ultrazohm/uz_d_gan_inverter_epc/GaN_Inverter/TikzCircuits/ThreePhaseInverter.tex

\documentclass{article}
\usepackage[fulldiodes]{circuitikz}
\usepackage{caption}
\usepackage{subcaption}
\usepackage{circuitikz}
\usepackage{graphicx}

\begin{document}
	
		\centering

		\begin{circuitikz}[scale=1.6]
			
			\centering
			
			\ctikzset{bipoles/resistor/height=0.15}
			\ctikzset{bipoles/resistor/width=0.4}
			\ctikzset{resistor = european}

			\draw (-1,2) to[european voltage source,v_=$V_{DC}$] ++(0,-3.77);
			\draw (-1,2)--(0,2) node[circ]{}  to[C,l=$C$] ++(0,-3.76) node[circ]{};
			
			\draw (0,2) to ++(2,0)  node[circ]{}
			to (6,2) -- ++(0,-0.3) node[Lnigbt,bodydiode,anchor=D,label={[label distance=10]100:$$}](S3){};
			
			\draw (4,2) node[circ]{};
			\draw (2,-1.76) node[circ]{};
			\draw (4,-1.76) node[circ]{};
			\draw (S3.E)  to (6,0)  node[circ,label={180:$V_{C}$}](vc){}
			to (6,-.5) node[Lnigbt,bodydiode,anchor=D,label={[label distance=10]100:$$}](s3){};
			\draw (s3.E) to ++(0,-0.3) to ++(-4,0);

			\draw (S3.B) node[circ,label={90:{$S_3$}}]{};
			\draw (s3.B) node[circ,label={90:{$S^*_3$}}]{};
			
			\draw (2,2) -- ++(0,-0.3) node[Lnigbt,bodydiode,anchor=D,label={[label 	distance=10]100:$$}](S1){} ;
			\draw (S1.E) to (2,0)  node[circ,label={180:$V_{A}$}](va){}
			to (2,-.5) node[Lnigbt,bodydiode,anchor=D,label={[label distance=10]100:$$}](s1){};
			\draw (s1.E) to ++(0,-0.3)  to  ++(-2,0) to [/tikz/circuitikz/bipoles/length=25pt, R = $R_{dc}$] ++(-1,0);
			\draw (S1.B) node[circ,label={90:{$S_1$}}]{};
			\draw (s1.B) node[circ,label={90:{$S^*_1$}}]{};
			
			\draw (4,2) -- ++(0,-0.3)   node[Lnigbt,bodydiode,anchor=D,label={[label distance=10]100:$$}](S2){};
			\draw (S2.E) to (4,0)  node[circ,label={180:$V_{B}$}](vb){}
			to (4,-.5) node[Lnigbt,bodydiode,anchor=D,label={[label distance=10]100:$$}](s2){};
			\draw (S2.B) node[circ,label={90:{$S_2$}}]{};
			\draw (s2.B) node[circ,label={90:{$S^*_2$}}]{};
			
			\draw (4,-1.46) -- ++(0,-0.3);
			\draw (2,-1.46) -- ++(0,-0.3);
			
			\draw (va) to ++(.75,0) to ++(0, -1.5) 
			to[/tikz/circuitikz/bipoles/length=25pt, R = $R_{s1}$] ++(0,-1.5)  node[ocirc]{};
			\draw (vb) to ++(.75,0) to ++(0, -1.5) 
			to[/tikz/circuitikz/bipoles/length=25pt, R = $R_{s2}$] ++(0,-1.5)  node[ocirc]{} ;
			\draw (vc) to ++(.75,0) to ++(0, -1.5)
			to[/tikz/circuitikz/bipoles/length=25pt, R = $R_{s3}$] ++(0,-1.5)   node[ocirc]{};
			\draw (6,-3.5) to[short, label=Phase 	Connector(1..3), below] ++(0,0);
			
			\path (1.6, 1) -- node[auto=false]{\ldots} ++(-1,0);
			\path (1.7,-1.2) -- node[auto=false]{\ldots} ++(-1,0);
			\path (3.6, 1) -- node[auto=false]{\ldots} ++(-1,0);
			\path (3.7,-1.2) -- node[auto=false]{\ldots} ++(-1,0);
			\path (5.6, 1) -- node[auto=false]{\ldots} ++(-1,0);
			\path (5.7,-1.2) -- node[auto=false]{\ldots} ++(-1,0);

	\end{circuitikz}

	\end{document}
