ultrazohm/uz_d_gan_inverter_epc/GaN_Inverter/HLU_Final_Presentation_Kaan_Ilhan.pdf

Chair of High-Power Converter Systems TUM School of Engineering and Design Technical University of Munich

Kaan Ilhan

M.Sc. Eyke Aufderheide

M.Sc. Tobias Schindler

Gean Maia de Sousa

23rd August, 2023

# Final Presentation of Bachelor’s Thesis

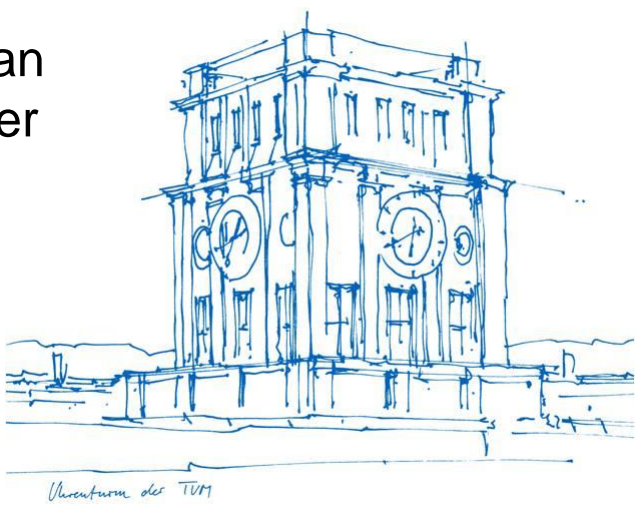
[picture p1: figure]

## Design and Implementation of an 1 kVA Three-Phase GaN Inverter

## Contents

1. Motivation
2. Gallium Nitride Power Transistor
3. Three-phase Two-level GaN Inverter
4. Parasitic Inductances
5. Layout Considerations
6. Thermal Considerations
7. Test and Measurement
8. References

## Motivation

- Using a three-phase two-level GaN inverter within

UltraZohm

- Improving the gate driver circuit of the existing GaN

inverter

- Optimizing the layout of the switching cells
- Implementing and commisioning
- Performance and thermal measurements

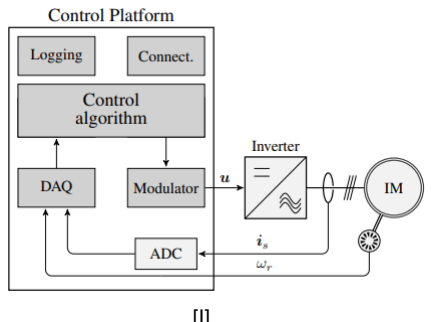
[picture p2: figure]

[I]

## Gallium Nitride Power Transistor

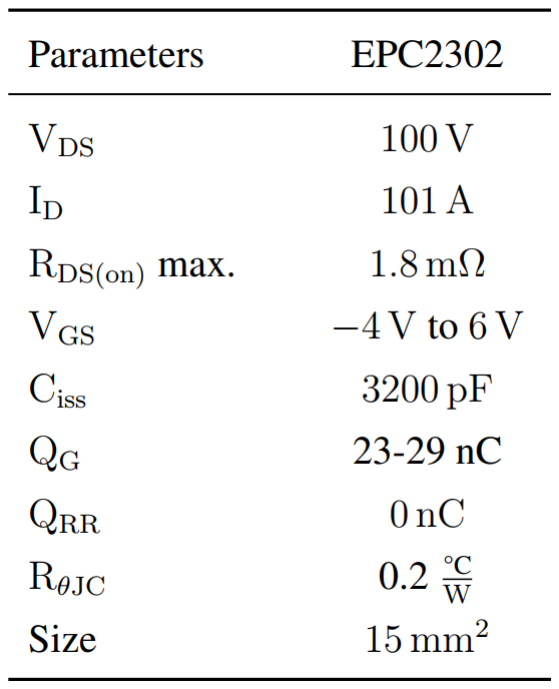
[picture p3: figure]

MOSFET Inverter

GaN Inverter

Benefits:

- Higher switching speed
- Higher efficiency
- Lower RDS(ON)

•Thermally enhanced package

- Smaller footprint, high power

density

## Three-phase Two-level GaN Inverter

- Absoulute maximum ratings:
Vdc = 48 V | Iout = 25 A
fPWM = 100 kHz | Tmax = 150°C
- Current and voltage measurements:
IOCP, leg = 40 A | IOCP, phase = 29.85 A

Vpeak = 60 V

- Temperature measurement of GaN HEMTs

Tpeak = 105°C

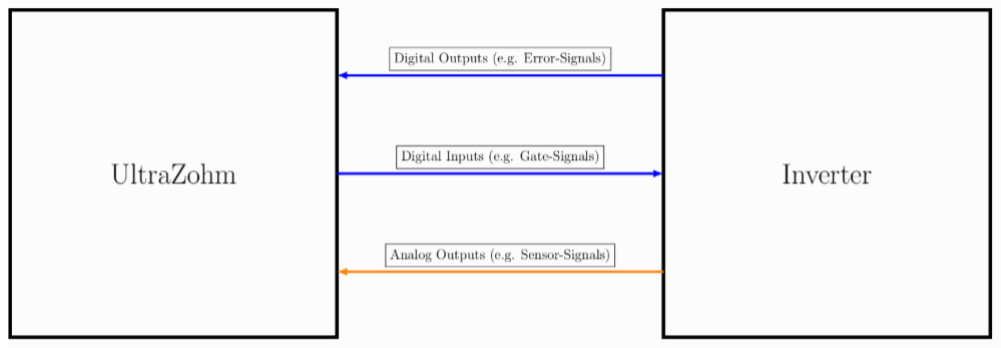
[picture p4: figure]

[II]

## Three-phase Two-level GaN Inverter

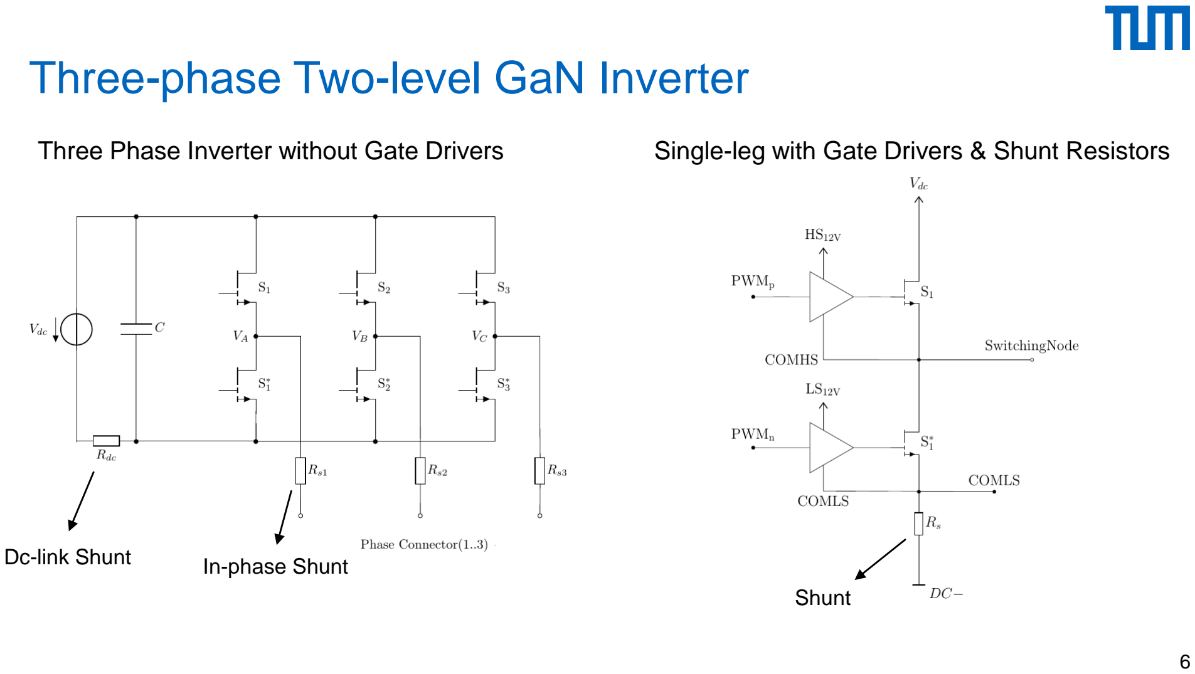
[picture p5: page 6]

Three Phase Inverter without Gate Drivers | Single-leg with Gate Drivers & Shunt Resistors
Dc-link Shunt | In-phase Shunt

Shunt

## Parasitic Inductances

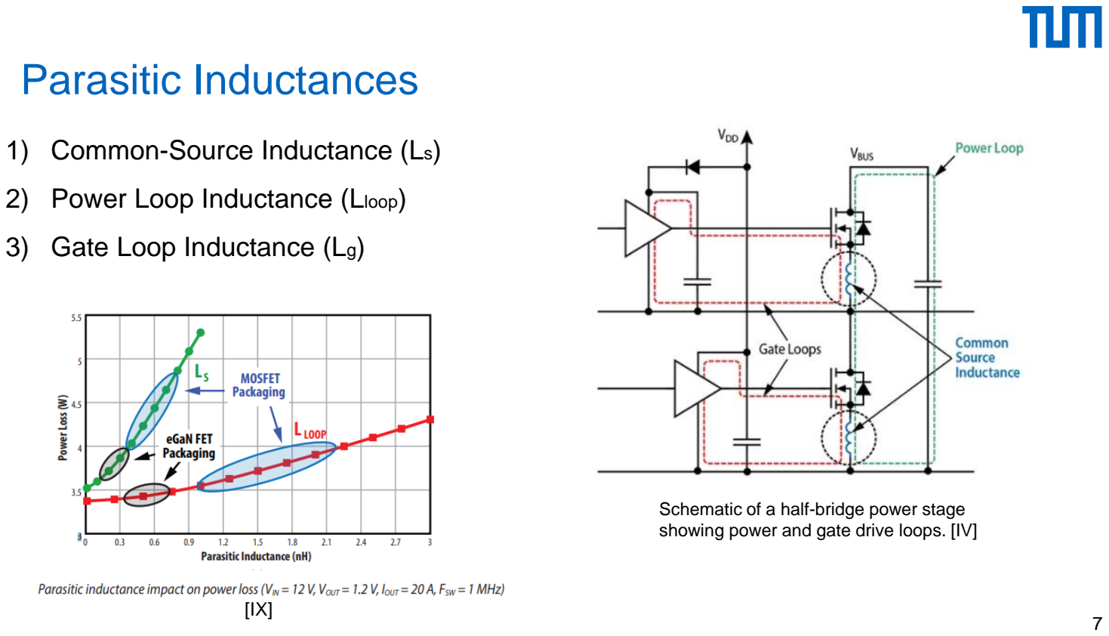
[picture p6: page 7]

1) Common-Source Inductance (Ls)
2) Power Loop Inductance (Lloop)
3) Gate Loop Inductance (Lg)

[IX]

Schematic of a half-bridge power stage showing power and gate drive loops. [IV]

- Ls is mainly controlled by the package inductance
- Overall reduction in parasitic inductance through

magnetic field self-cancellation

CSI is minimized

- Ls is no longer major loss contributor, but Lloop

## Optimal GaN FET Layout

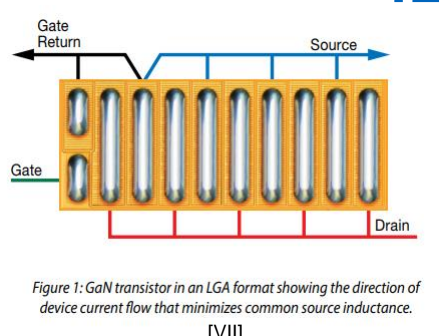
[picture p7: figure]

[VII]

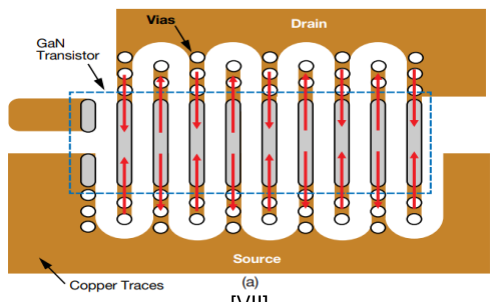
[picture p8: figure]

[VII]

## Comparison of Power Loop Layouts

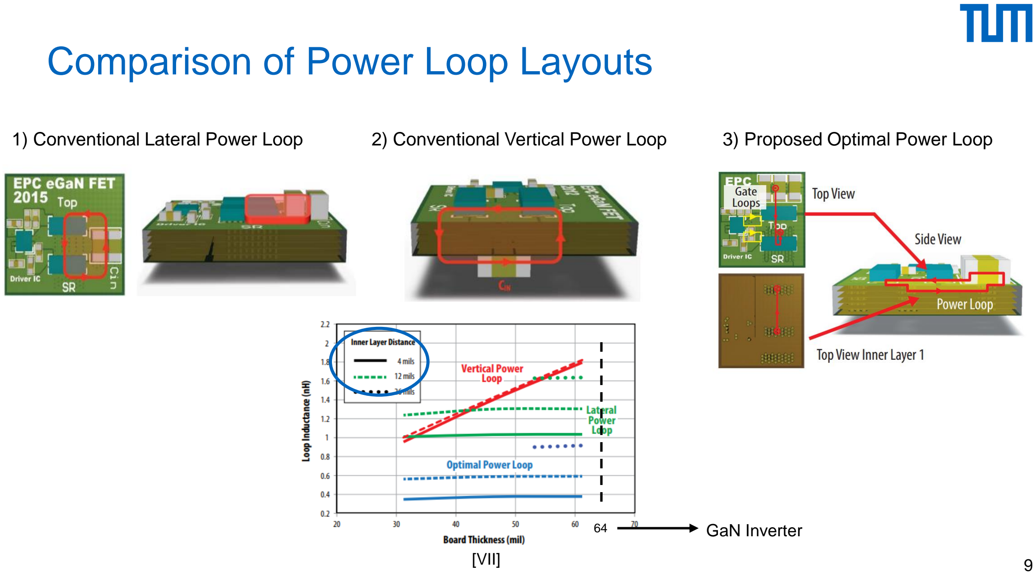
[picture p9: page 9]

64

1) Conventional Lateral Power Loop | 2) Conventional Vertical Power Loop | 3) Proposed Optimal Power Loop

[VII]

GaN Inverter

## Optimal Layout of Power and Gate Loops

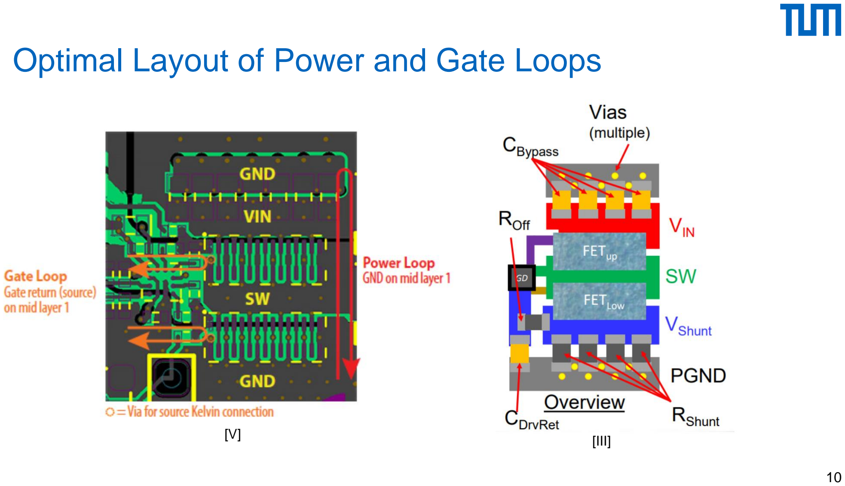
[picture p10: page 10]

[V] | [III]

## Vias Plated Over

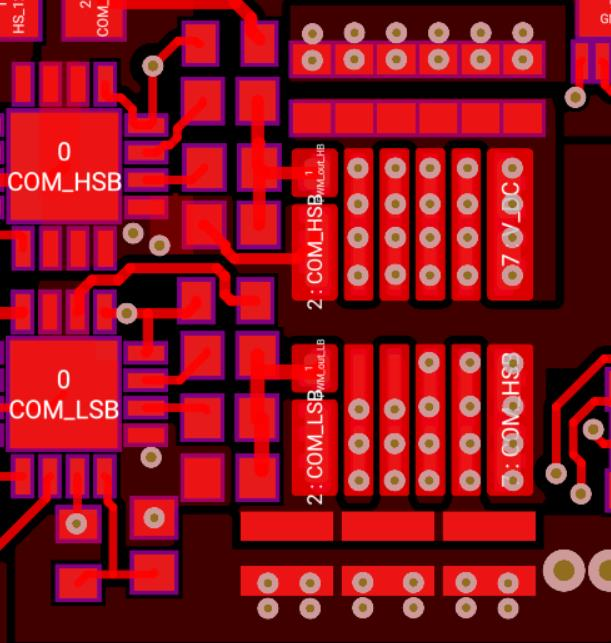
[picture p11: figure]

- Vias must be filled with epoxy and high termal

conductivity copper

- Minimizes the signal path lengths, decreasing

the parasitics

- Costly and complex to produce

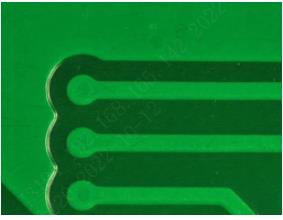
[picture p12: figure]

[VIII]

## Thermal Considerations

- Prepared for a heatsink installation
- Four holes of M3 are placed to allow screws
- Careful placement of thermal vias and power

planes to spread the heat

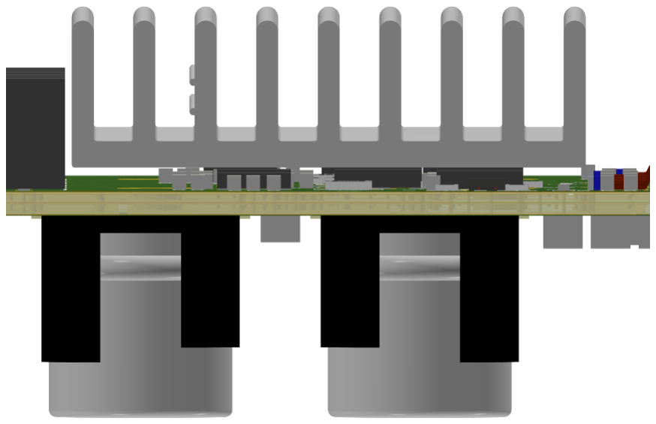
[picture p13: figure]

- Epoxy-filled vias to improve heat dissipation

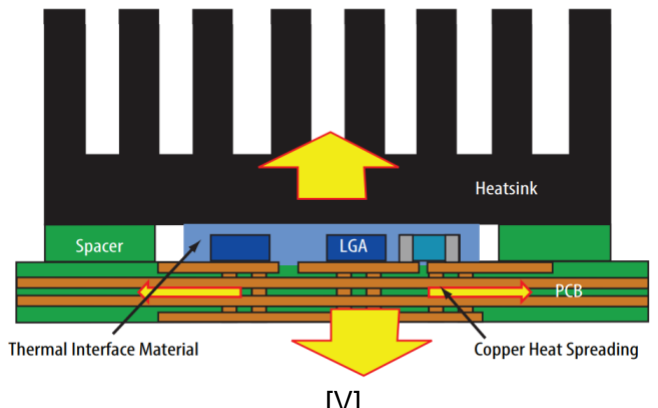
[picture p14: figure]

[V]

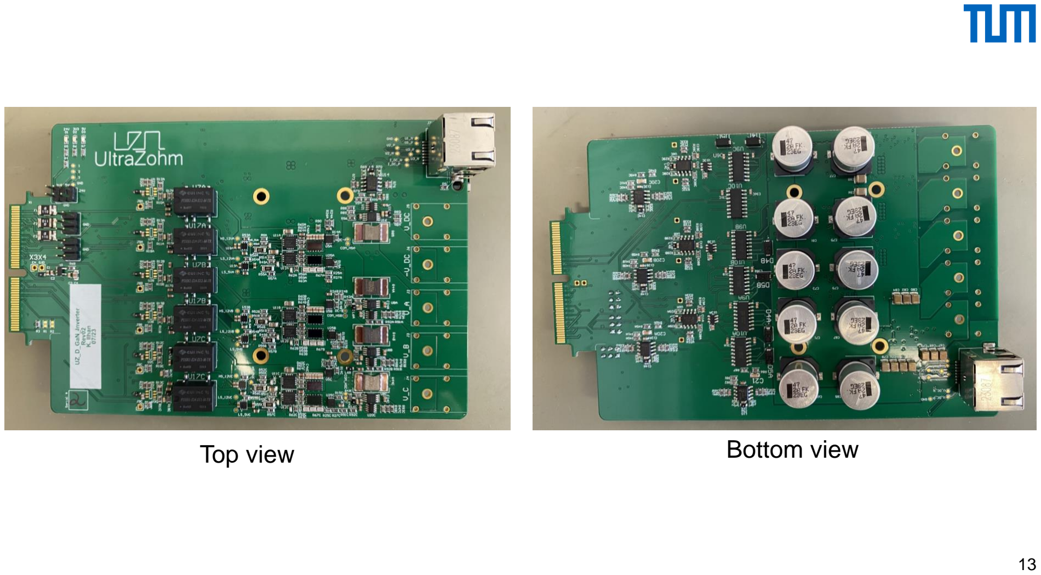
[picture p15: page 13]

Top view | Bottom view

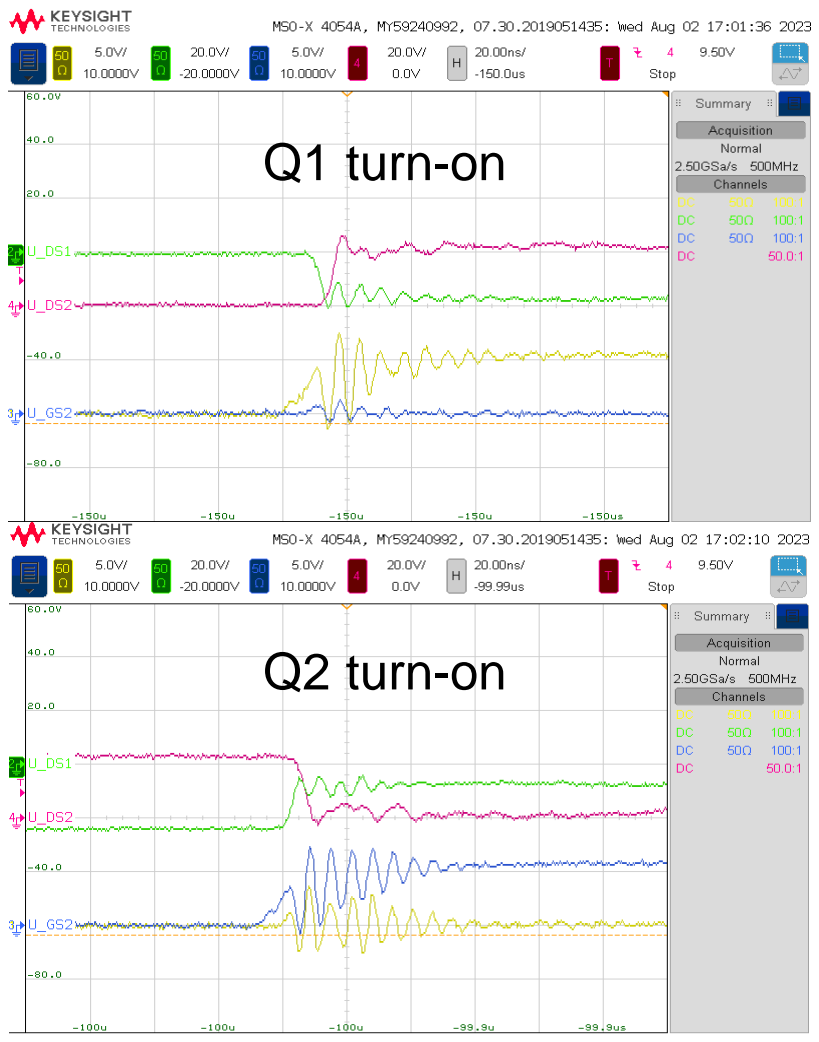
[picture p16: figure]
Q1 turn-on; Q2 turn-on

## Measurement Results (M3)

- VGS1 | yellow
VDS1 | green
- VGS2 | blue
VDS2 | pink
- Vdc = 24 V, fPWM = 10 kHz
- ISRC = 2 A, RON = 2.7 Ω, ROFF = 2.7 Ω

Q1 (top switch)

Q2 (bottom switch)

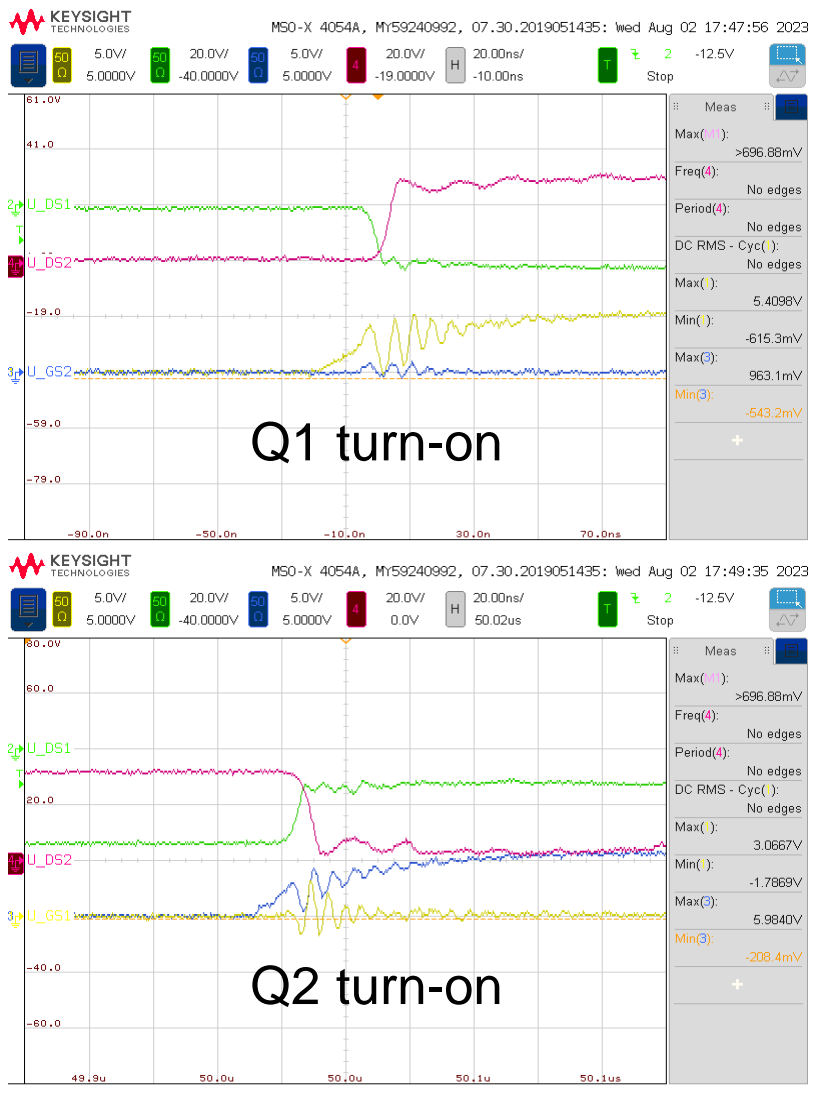
[picture p17: figure]
Q1 turn-on; Q2 turn-on

## Measurement Results (M4)

- VGS1 | yellow
VDS1 | green
- VGS2 | blue
VDS2 | pink
- Vdc = 34 V, fPWM = 10 kHz
- ISRC = 0.75 A, RON = 2.7 Ω, ROFF = 2.7 Ω,

Q1 (top switch)

Q2 (bottom switch)

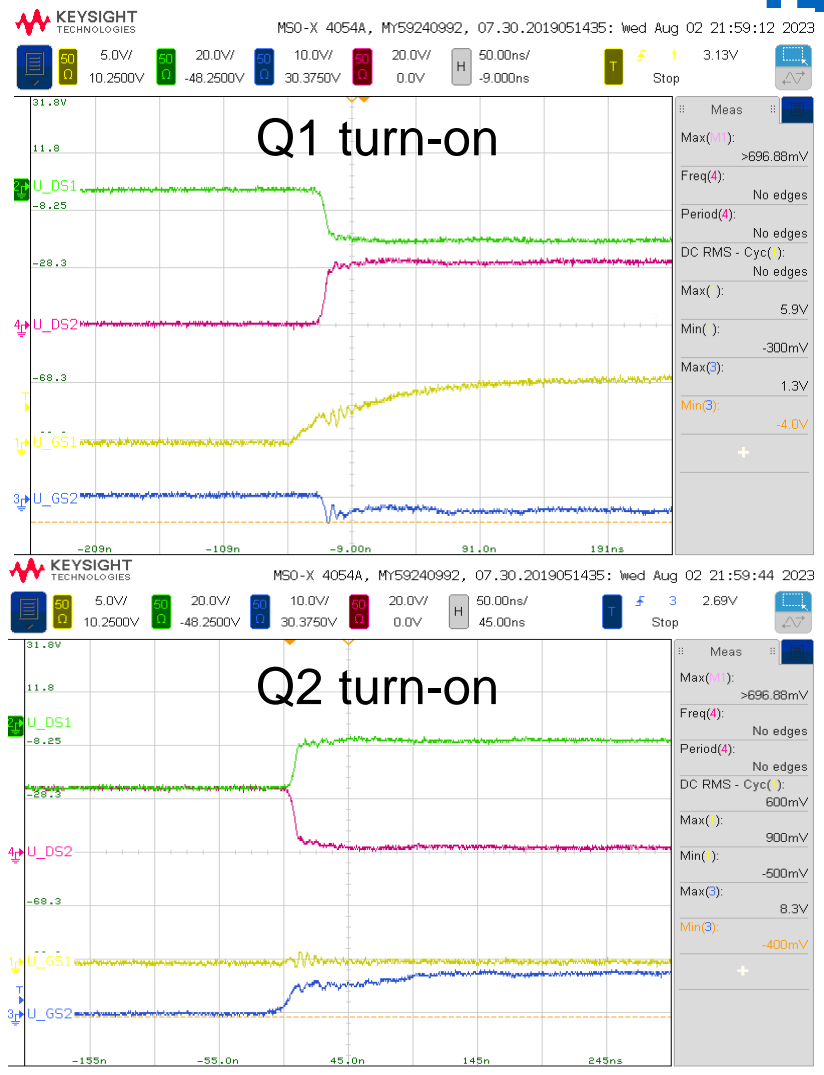
[picture p18: figure]
Q1 turn-on; Q2 turn-on

## Measurement Results (M5)

- VGS1 | yellow
VDS1 | green
- VGS2 | blue
VDS2 | pink
- Vdc = 24 V, fPWM = 10 kHz
- ISRC = 0.75 A, RON = 10 Ω, ROFF = 2.7 Ω,

Q1 (top switch)

Q2 (bottom switch)

## Thermal Measurements

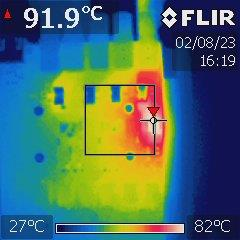
[picture p19: figure]

Temperature measurement with IOUT = 24 A at fPWM = 10 kHz, Vdc = 48 V, ISRC = 0.75 A and RON = 10 Ω, ROFF = 2.7 Ω, dead-time = 1 µs

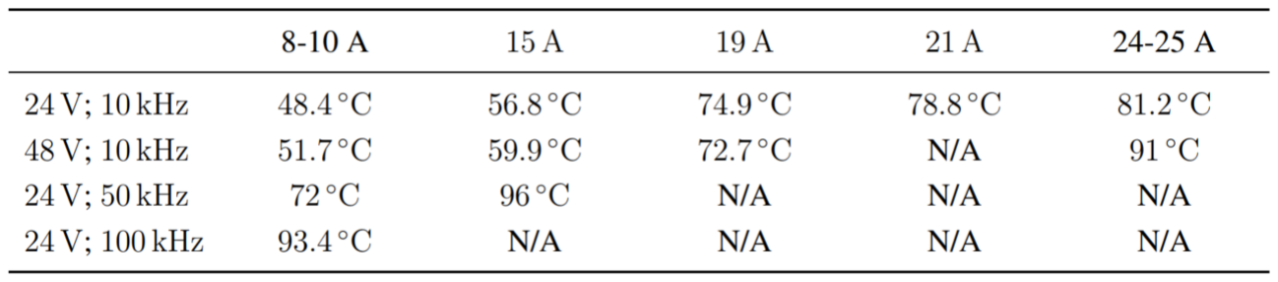
[picture p20: figure]

Temperatures of the GaN devices at various measurement points without heat sink

with ISRC = 0.75 A, RON = 10 Ω, ROFF = 2.7 Ω, dead-time = 1 µs
Reasons:
- Slow switching speed with the selected values of ISRC and RON

Finding an optimal compromise

- Dead-time value

## References:

I. https://docs.ultrazohm.com/hardware/adaptercards/adapter_cards.html
II. | https://docs.ultrazohm.com/hardware/interface_powerelectronics/interface_powerelectronics.html
III. | https://epc-co.com/epc/Portals/0/epc/documents/presentations/High-
| Performance%20Layout%20Techniques%20to%20Maximize%20GaN%20Device%20Performance.pdf
IV. | https://epc-co.com/epc/products/gan-fets-and-ics/epc2302
V. https://epc-co.com/epc/design-support
VI. | https://epc-
| co.com/epc/Portals/0/epc/documents/papers/eGaN%20FET%20Drivers%20and%20Layout%20Considerations.pdf

VII. https://epc-co.com/epc/Portals/0/epc/documents/papers/Optimizing%20PCB%20Layout%20with%20eGaN%20FETs.pdf

VIII. https://jlcpcb.com/help/article/122-Via-Covering:-Tented,-Untented,-Plugged,-Epoxy-Filled-and-Copper-epoxy-

| filled?_ga=2.144944244.1925759732.1683636865-514213861.1683548810 (https://jlcpcb.com/help/article/122-Via-Covering:-Tented,-Untented,-Plugged,-Epoxy-Filled-and-Copper-epoxy-filled)
IX. | https://epc-co.com/epc/Portals/0/epc/documents/product-training/AN003%20Using%20Enhancement%20Mode%20GaN-on-
| Silicon.pdf
X. https://www.nae.fr/layout-considerations-for-gan-transistor-circuits-technical-articles/
