ultrazohm/uz_d_gan_inverter_epc/GaN_Inverter/TikzCircuits/DcLinkSensing.pdf

RDC

i

−

+

Sense- Sense+

OCP
FPGA

ADC

1
