ultrazohm/uz_d_gan_inverter_epc/GaN_Inverter/TikzCircuits/SingleLegWithGateDrivers.pdf

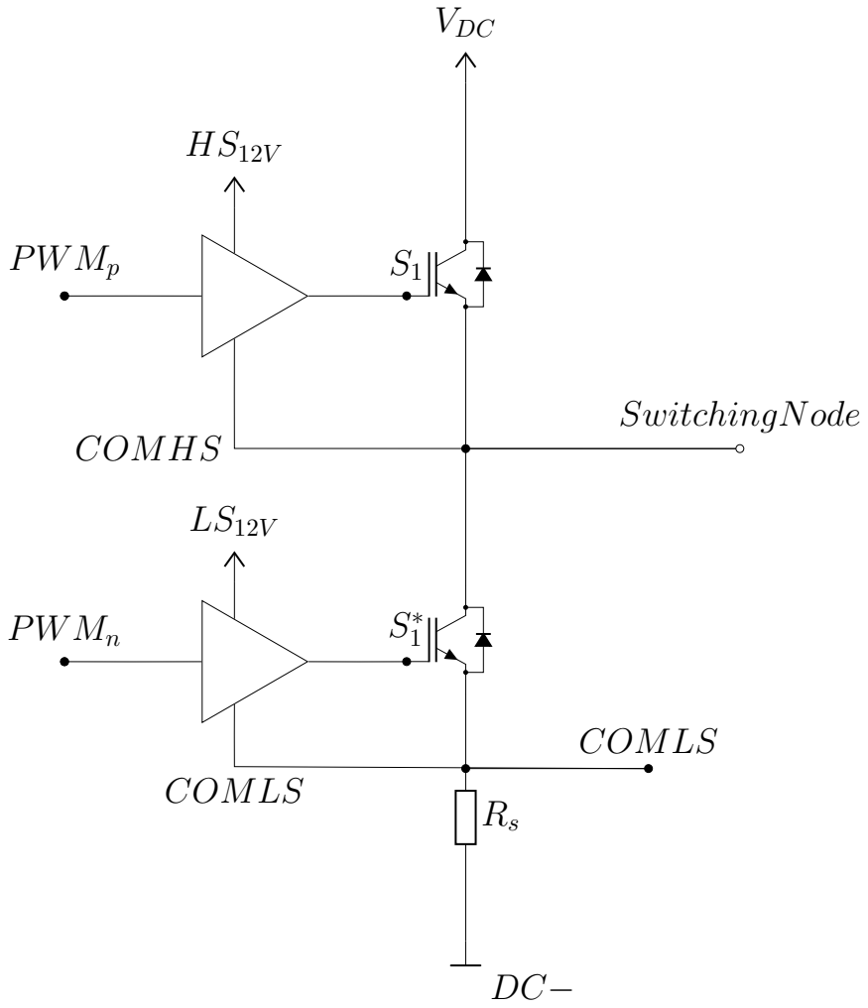
[picture p21: figure]
VDC; SwitchingNode; COMLS; PWMp; COMHS; PWMn

1
