ultrazohm/uz_d_gan_inverter_epc/GaN_Inverter/TikzCircuits/CurrentSensing.pdf

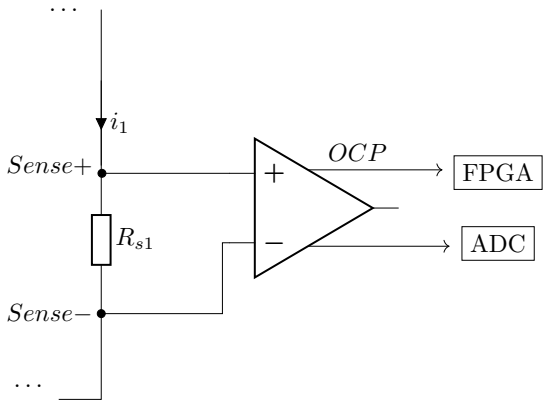
[picture p22: figure]
Sense−; Sense+; OCP; FPGA; ADC

1
