ultrazohm/uz_d_gan_inverter_epc/GaN_Inverter/Project Outputs for GanInverter/Rev02/BOM/BOM_GanInverter_Inverter_V1_Rev02.xlsx

Name | Designator | Footprint | LCSC Part Number
1 µF | C1, C23A, C23B, C23C, C34A, C34B, C34C, C35A, C35B, C35C, C40A, C40B, C40C, C42A, C42B, C42C, C66 | C_0603 | C105174
100nF | C2, C3, C7A, C7B, C7C, C8A, C8B, C8C, C9A, C9B, C9C, C10A, C10B, C10C, C11A, C11B, C11C, C12A, C12B, C12C, C13A, C13B, C13C, C14A, C14B, C14C, C19A, C19B, C19C, C24A, C24B, C24C, C26A, C26B, C26C, C28A, C28B, C28C, C31A, C31B, C31C, C36A, C36B, C36C, C46A, C46B, C46C, C47A, C47B, C47C, C48A, C48B, C48C, C49A, C49B, C49C, C50A, C50B, C50C, C51A, C51B, C51C, C52A, C52B, C52C | C_0603 | C342825
10 µF | C4, C39A, C39B, C39C, C41A, C41B, C41C | C_0805 | C15850
10nF | C5A, C5B, C5C, C6A, C6B, C6C, C22A, C22B, C22C, C65 | C_0603 | C136131
56 pF | C15A, C15B, C15C, C16A, C16B, C16C, C17A, C17B, C17C, C57, C59, C60 | C_0603 | C39148
0.01 µF | C18A, C18B, C18C, C58 | C_0603 | C343007
0.01 µF | C20A, C20B, C20C, C21 | C_0805 | C2691724
4.7 µF | C25A, C25B, C25C, C27A, C27B, C27C, C29A, C29B, C29C, C30A, C30B, C30C, C44A, C44B, C44C, C45A, C45B, C45C | C_0603 | C162274
2.2 uF | C32A, C32B, C32C, C33A, C33B, C33C | C_0603 | C2929194
22 pF | C37A, C37B, C37C, C38A, C38B, C38C, C43A, C43B, C43C | C_0603 | C2240294
100 nF | C53, C54, C55, C56, C61, C64, C89A, C89B, C89C, C90 | C_0603 | C14663
10 µF | C67, C68, C70, C72, C74, C76, C78, C80, C82, C84, C86, C88 | C_1210_N | C576517
47µF | C69, C71, C73, C75, C77, C79, C81, C83, C85, C87 | EEEFK0J332AV | C401732
19-213/Y2C-CQ2R2L/3T(CY) | D1 | WL-SMCW_0603 | C72038
150060RS86000 | D2 | WL-SMCW_0603 | C389517
FC-DA1608HOK-600H | D3 | WL-SMCW_0603 | C84269
DNP | D4A, D4B, D4C, D5A, D5B, D5C | FP-GF1M-E3-67A-MFG | C3008881
Littelfuse_PTC_1812 | F1, F2, F3 | 1812_PTC_Polyfuse_Littelfuse | C70119
6339160-1 | J1, J7 | 634008149821 | C125076
FCR7350B, PCB mount 4mm jack, BLACK | J2, J3, J4 | FCR7350
FCR7350R, PCB mount 4mm jack, RED | J5 | FCR7350
FCR7350L, PCB mount 4mm jack, BLUE | J6 | FCR7350
4-103327-3 | J8A, J8B, J8C, J9A, J9B, J9C, X3, X4 | 1_Pin_Header | C3347196
6.8uH | L1, L2A, L2B, L2C, L3A, L3B, L3C, L4A, L4B, L4C, L5A, L5B, L5C, L6A, L6B, L6C, L7A, L7B, L7C, L8A, L8B, L8C, L9, L10, L11 | INDC1608X95N | C961362
EPC2302 | Q1A, Q1B, Q1C, Q2A, Q2B, Q2C | D0606F_100V | C5353503
DNP | R3, R68, R92A, R92B, R92C, R95 | RES 0603_1608 | C21189
10k | R4, R10A, R10B, R10C, R11A, R11B, R11C, R14A, R14B, R14C, R15A, R15B, R15C, R16A, R16B, R16C, R18A, R18B, R18C, R34A, R34B, R34C, R37A, R37B, R37C, R40A, R40B, R40C, R45A, R45B, R45C, R51A, R51B, R51C, R52A, R52B, R52C, R75, R77, R81, R86 | RES 0603_1608 | C25804
20k | R5, R17A, R17B, R17C, R19A, R19B, R19C | RES 0603_1608 | C4184
2k4 | R6 | RES 0603_1608 | C881363
6k8 | R7 | RES 0603_1608 | C118365
0R | R8, R9, R57A, R57B, R57C, R90, R91A, R91B, R91C, R93A, R93B, R93C, R94, R96 | RES 0603_1608 | C21189
287k | R12A, R12B, R12C, R13A, R13B, R13C | RES 0805_2012 | C228683
182k | R20A, R20B, R20C, R21A, R21B, R21C | RES 0603_1608 | C203368
976k | R22A, R22B, R22C, R23A, R23B, R23C | RES 0603_1608 | C162980
105k | R24A, R24B, R24C, R25A, R25B, R25C | RES 0603_1608 | C141685
280k | R26A, R26B, R26C, R27A, R27B, R27C | RES 0603_1608 | C861797
49R9 | R28A, R28B, R28C, R29A, R29B, R29C, R30A, R30B, R30C, R31A, R31B, R31C, R69, R70, R71, R72 | RES 0603_1608 | C2075693
2k | R32A, R32B, R32C, R33A, R33B, R33C, R43A, R43B, R43C, R73, R76, R84 | RES 0603_1608 | C705921, C189729
110k | R35A, R35B, R35C, R36A, R36B, R36C, R41A, R41B, R41C, R46A, R46B, R46C, R74, R78, R82, R87 | RES 0603_1608 | C168275
1k | R38A, R38B, R38C, R39A, R39B, R39C, R48A, R48B, R48C, R79, R80, R89 | RES 0603_1608 | C51218
3k9 | R42A, R42B, R42C, R47A, R47B, R47C, R83, R88 | RES 0603_1608 | C863790
2mR | R44A, R44B, R44C, R85 | 3921 | C2090244
220R | R49A, R49B, R49C, R50A, R50B, R50C | RES 0603_1608 | C327834
100k | R53A, R53B, R53C, R54A, R54B, R54C | RES 0603_1608 | C237792
1M | R55A, R55B, R55C, R56A, R56B, R56C | RES 1206_3216 | C253347
2R7 | R58A, R58B, R58C, R59A, R59B, R59C, R60A, R60B, R60C, R61A, R61B, R61C | RES 0603_1608 | C2849050
5R6 | R62A, R62B, R62C | RES 0603_1608 | C2849053
3k3 | R63A, R63B, R63C, R64A, R64B, R64C | RES 0603_1608 | C22978
3mR | R65A, R65B, R65C, R66A, R66B, R66C, R67A, R67B, R67C | FP-KRL2012-MFG | C4057585
REF4132B25DBVRQ1 | U1 | SOT95P280X145-5N | C2871658
LTC6992HS6-4#WTRMPBF | U2A, U2B, U2C, U3A, U3B, U3C | SOT95P280X100-6N | C3304518
ADA4940-1ARZ-R7 | U4A, U4B, U4C, U6A, U6B, U6C, U14, U15 | SOT127P600X175-8N | C730049
LM57CISD-10/NOPB | U5A, U5B, U5C, U25A, U25B, U25C | SON50P250X250X80-9N | C2864091
PDSE1-S24-S12-M-TR | U7A, U7B, U7C, U17A, U17B, U17C | PDSE1S24S12MTR | C6730719
Value | U8A, U8B, U8C, U16 | SOP65P490X110-8N | C4550714
 | U9A, U9B, U9C, U10A, U10B, U10C | SOIC127P600X175-16N | C402923
RAA2261104GNP#HA0 | U11A, U11B, U11C, U12A, U12B, U12C | RAA2261104GNP#HA0 | C3654979
SN74LVC2G14DBVR | U13A, U13B, U13C | SOT95P280X145-6N | C12401
5V | U18A, U18B, U18C, U19A, U19B, U19C | SON65P200X200X80-7N | C892822
INA241B1IDDFR | U20A, U20B, U20C, U21 | SOT65P280X110-8N | C7433256
2.54-2*3 | X2, X5, X6 | SAMTEC_TSW-103-05-G-D | C5116479
