ultrazohm/uz_d_gan_inverter_epc/GaN_Inverter/TikzCircuits/ThreePhaseInverter.pdf

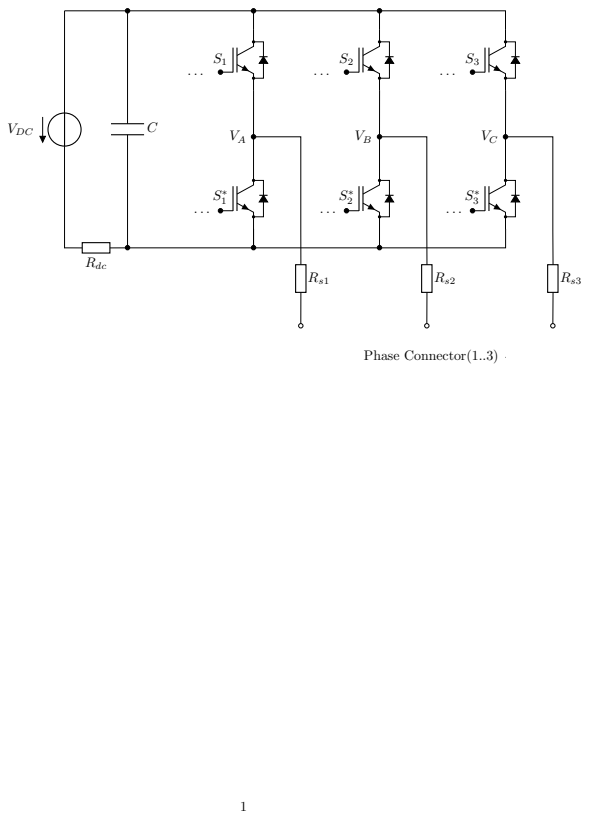
[picture p23: page 1]
VDC; Rdc; Phase Connector(1..3)
