ultrazohm/uz_d_gan_inverter_epc/GaN_Inverter/Project Outputs for GanInverter/Rev01/SCH_GanInverter_Inverter_V1_Rev01.PDF

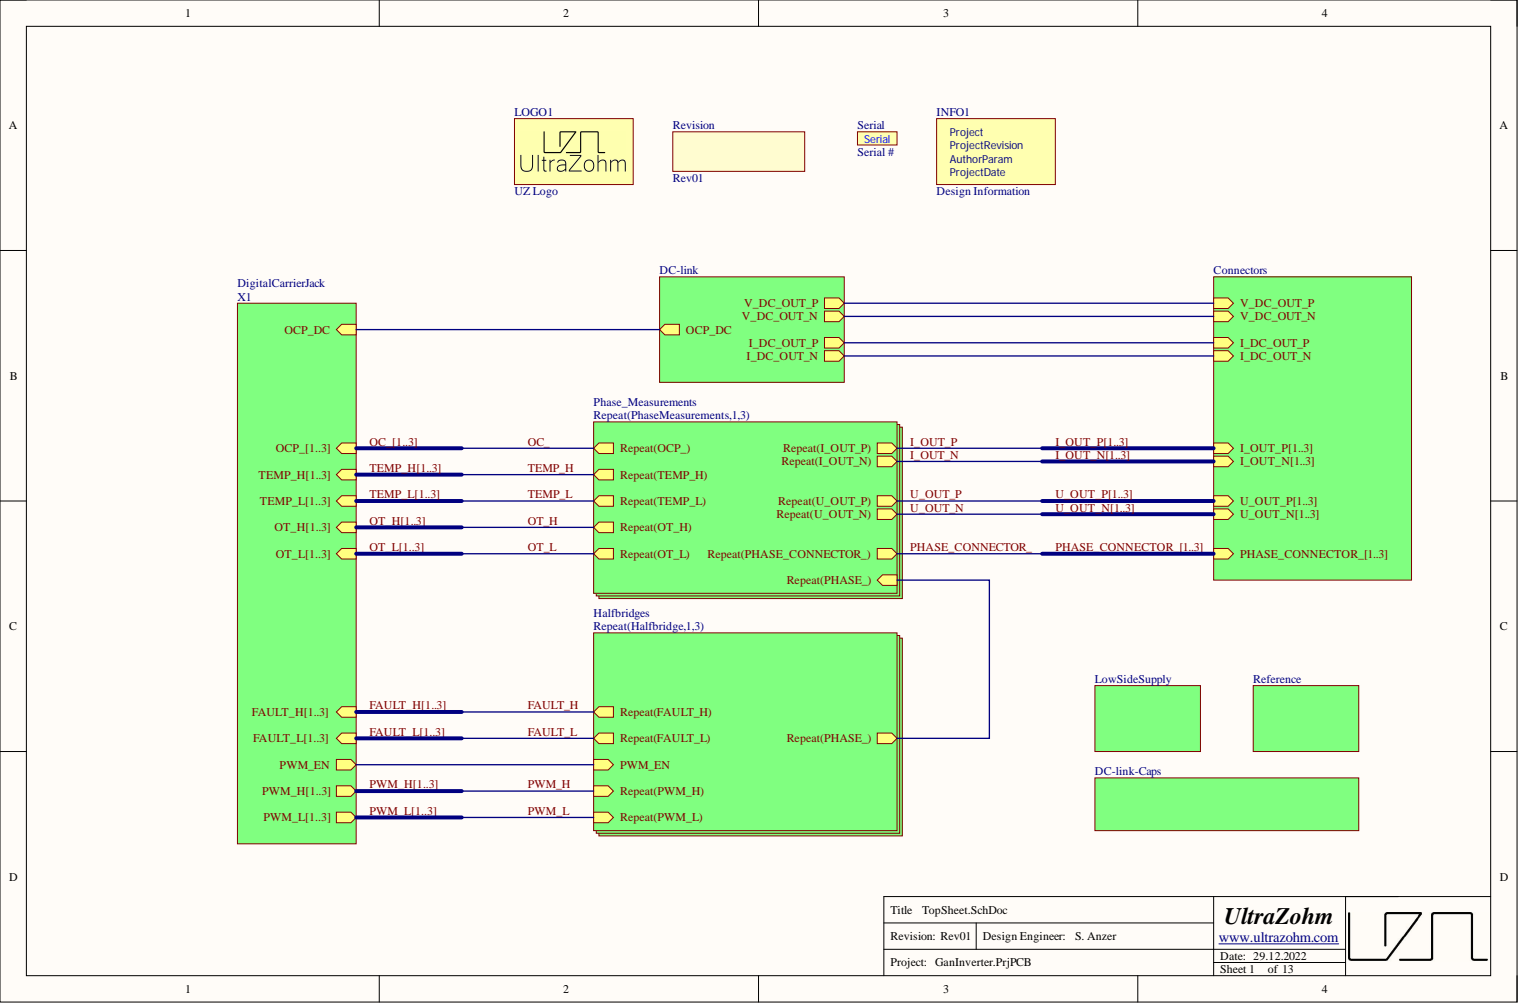
[picture p24: page 1]

Revision:

Date: 29.12.2022

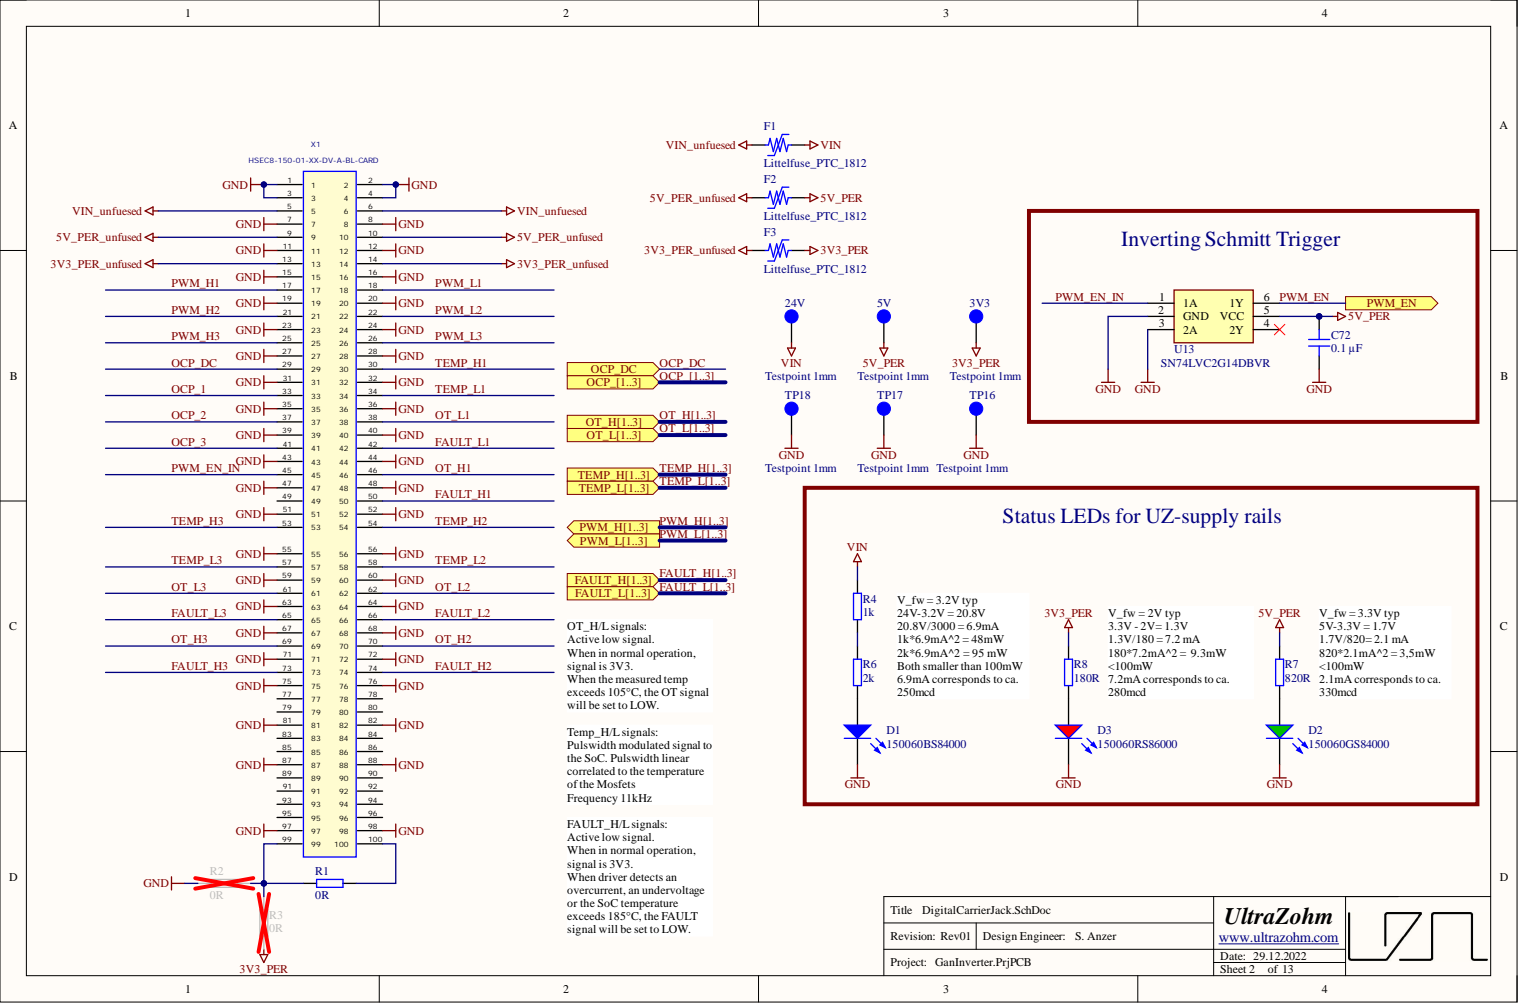
[picture p25: page 2]

Status LEDs for UZ-su

Rev i s i o n :

Dat e : .

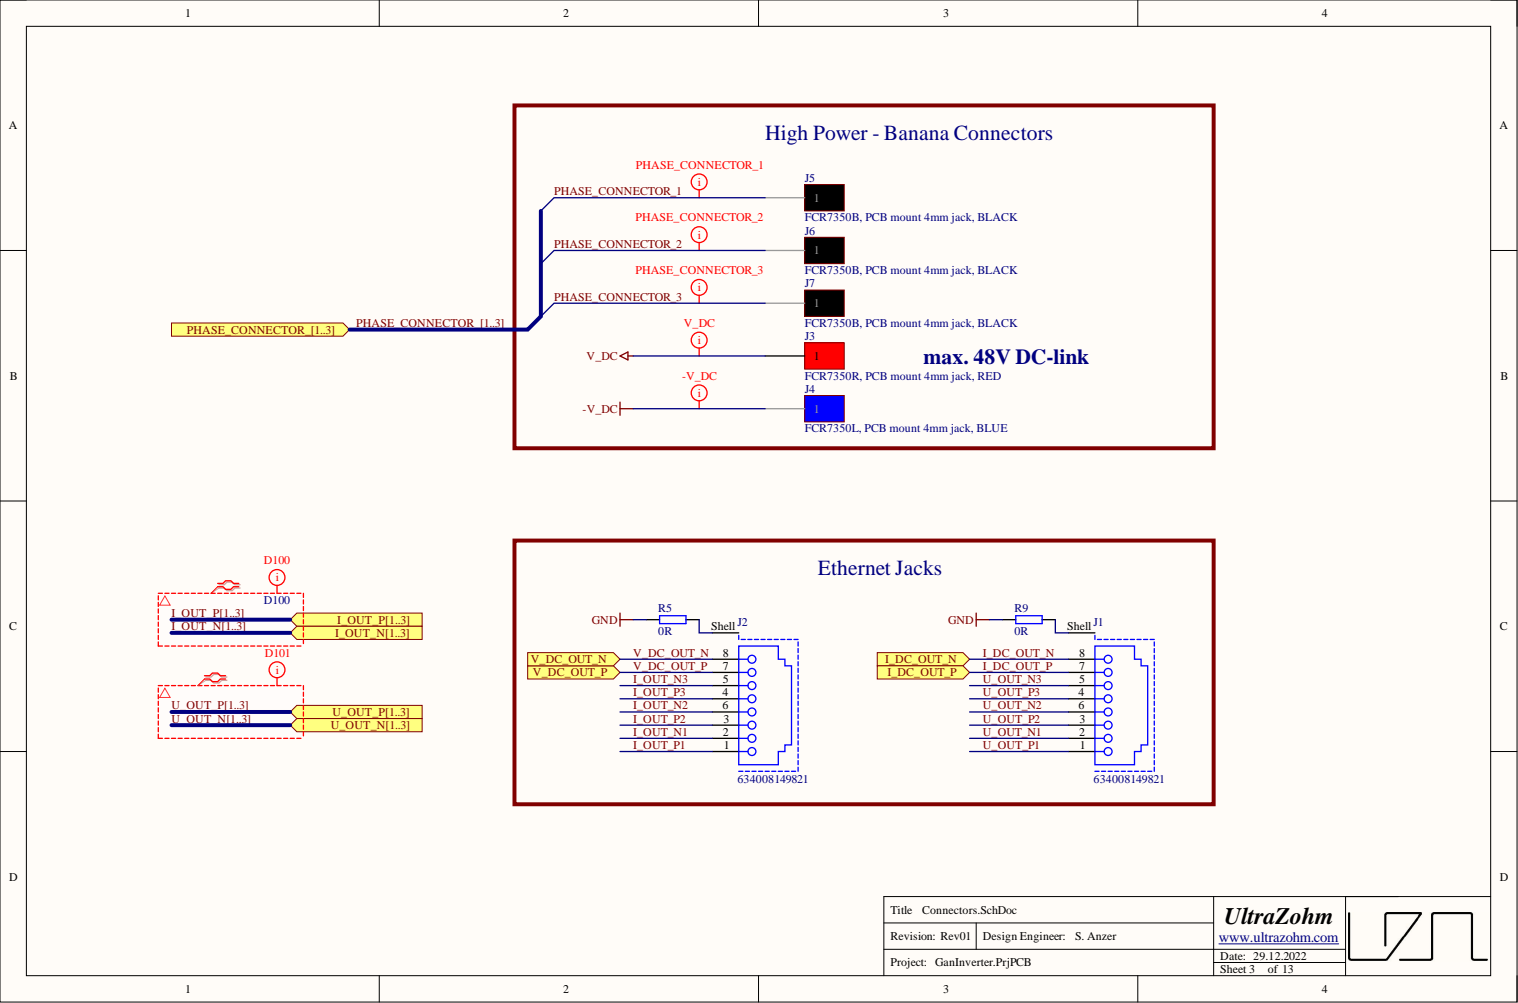
[picture p26: page 3]

High Power - Banana Connectors

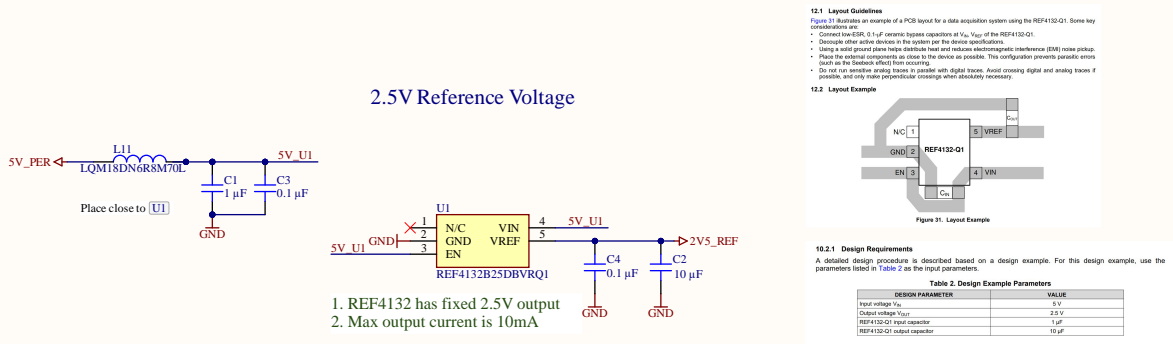
[picture p27: page 4]

Rev i s i o n :

Dat e : .

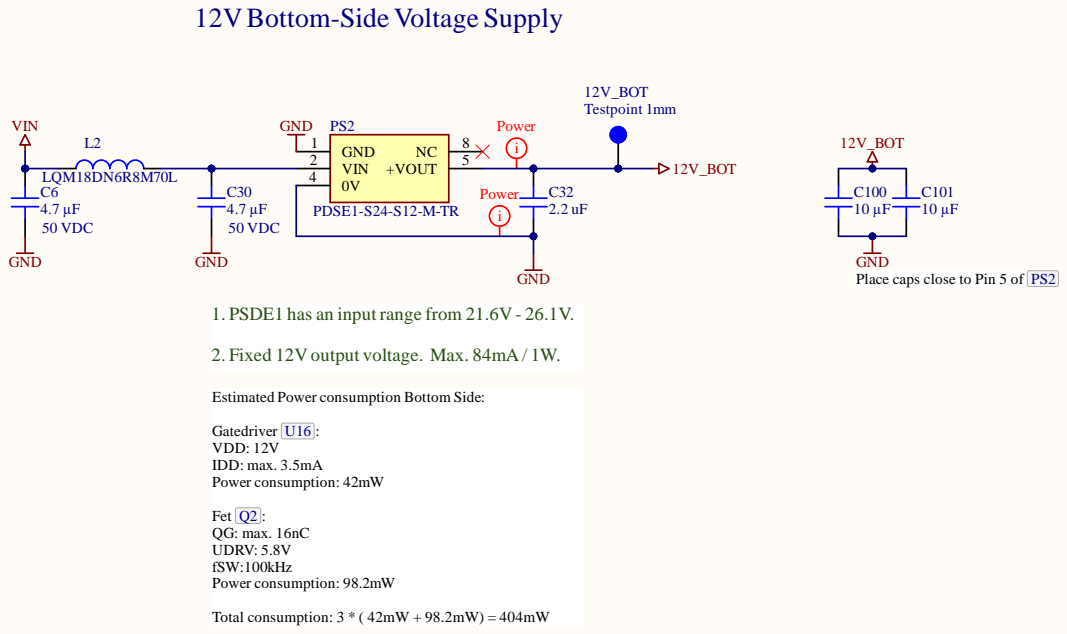
[picture p28: page 5]

Rev i s i o n :

Dat e : .

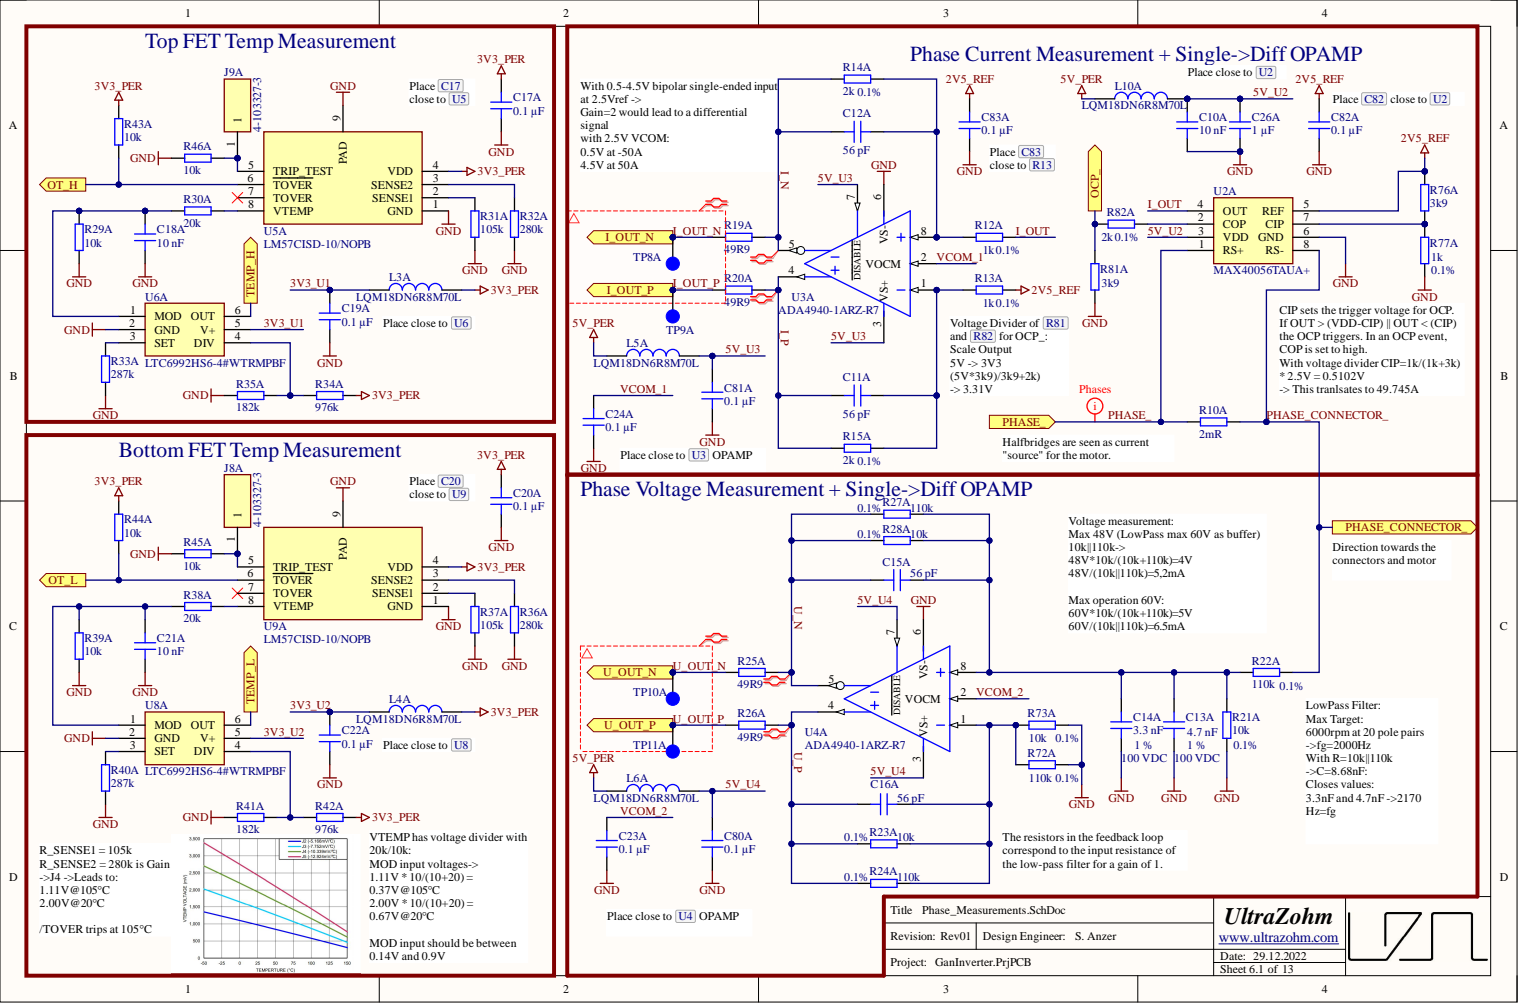
[picture p29: page 6]

Phase Current Measurement + Single->Diff OPAMP Top FET Temp Measurement

With 0.5-4.5V bipolar single-ended input
at 2.5Vref ->
Gain=2 would lead to a differential
signal
with 2.5V VCOM:

CIP sets the trigger voltage for OCP.
If OUT > (VDD-CIP) || OUT < (CIP)
the OCP triggers. In an OCP event,
COP is set to high.
With voltage divider CIP=1k/(1k+3k)
-> This tranlsates to 49.745A

GND
Bottom FET Temp Measurement

Halfbridges are seen as current
"source" for the motor.

Place close to U3 OPAMP
Phase Voltage Measurement + Single->Diff OPAMP

The resistors in the feedback loop
correspond to the input resistance of
the low-pass filter for a gain of 1.

Place close to U4 OPAMP

MOD input should be between
0.14V and 0.9V

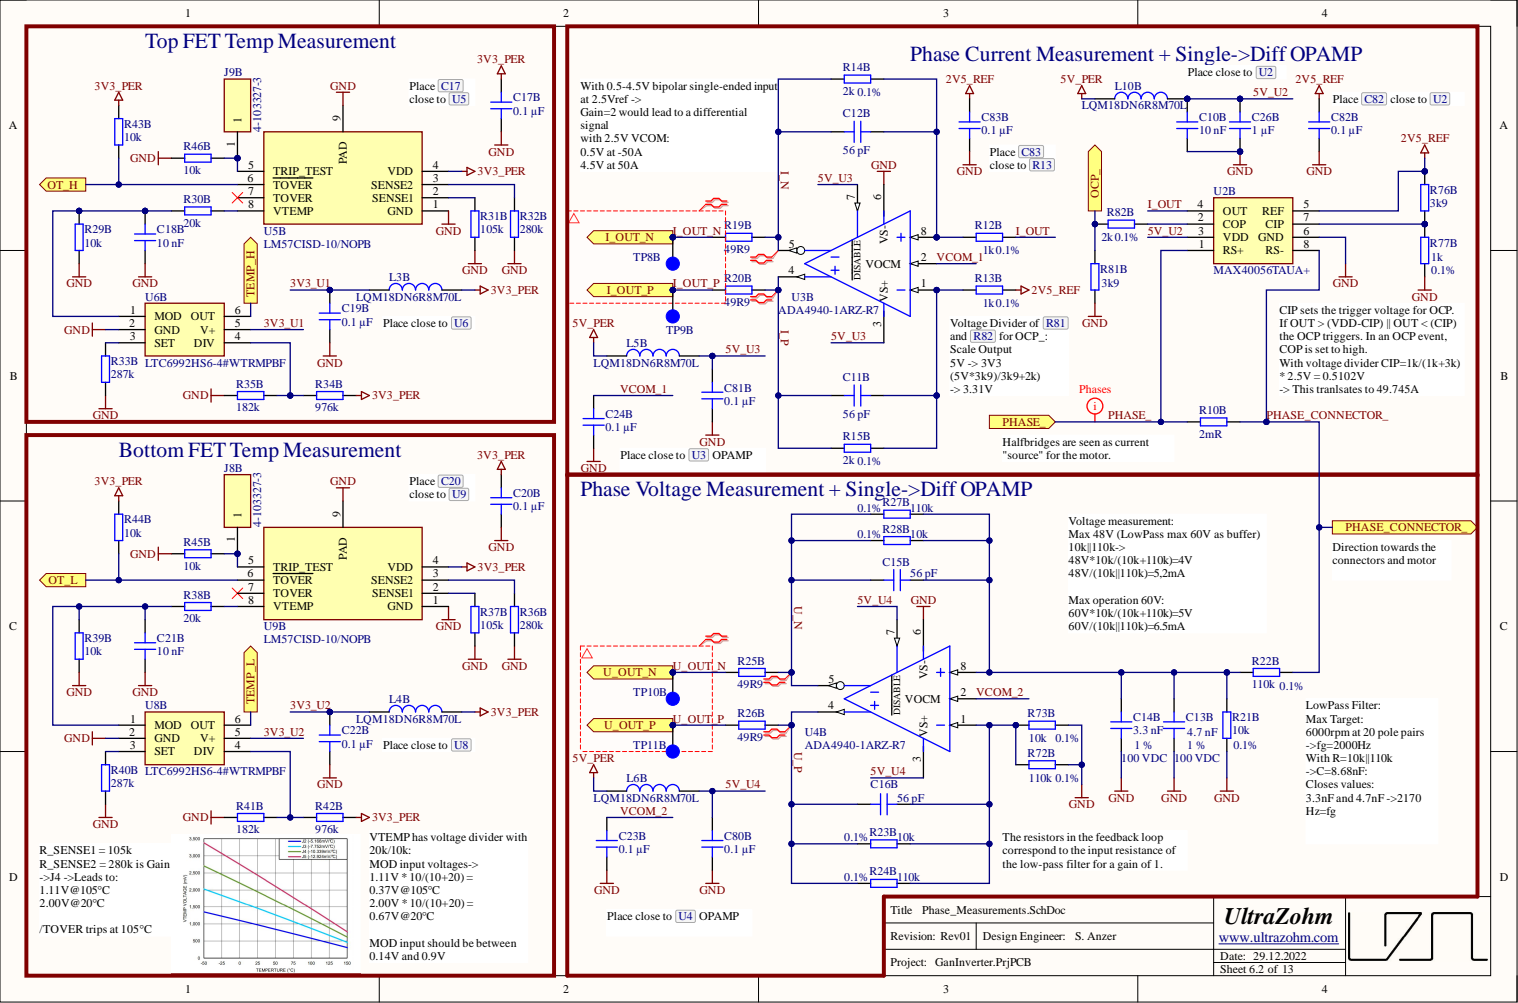
[picture p30: page 7]

Phase Current Measurement + Single->Diff OPAMP Top FET Temp Measurement

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

GND
Bottom FET Temp Measurement

Halfbridges are seen as current
"source" for the motor.

Place close to U3 OPAMP
Phase Voltage Measurement + Single->Diff OPAMP

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

Place close to U4 OPAMP

MOD input should be between
0.14V and 0.9V

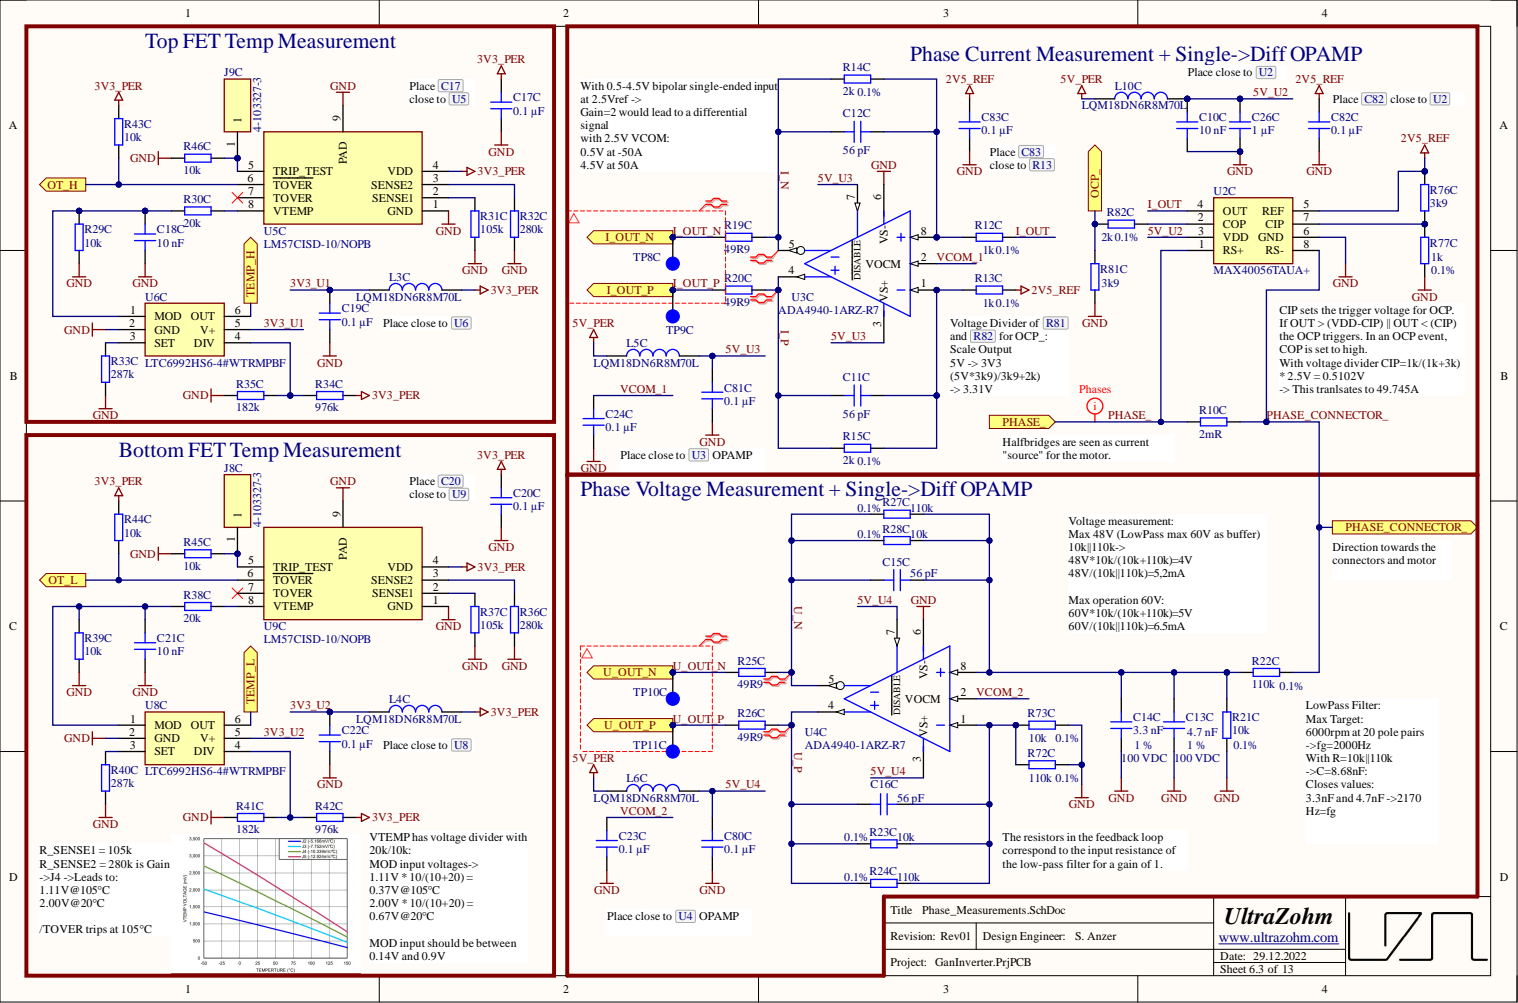
[picture p31: page 8]

Phase Current Measurement + Single->Diff OPAMP Top FET Temp Measurement

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

GND
Bottom FET Temp Measurement

Halfbridges are seen as current
"source" for the motor.

Place close to U3 OPAMP
Phase Voltage Measurement + Single->Diff OPAMP

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

Place close to U4 OPAMP

MOD input should be between
0.14V and 0.9V

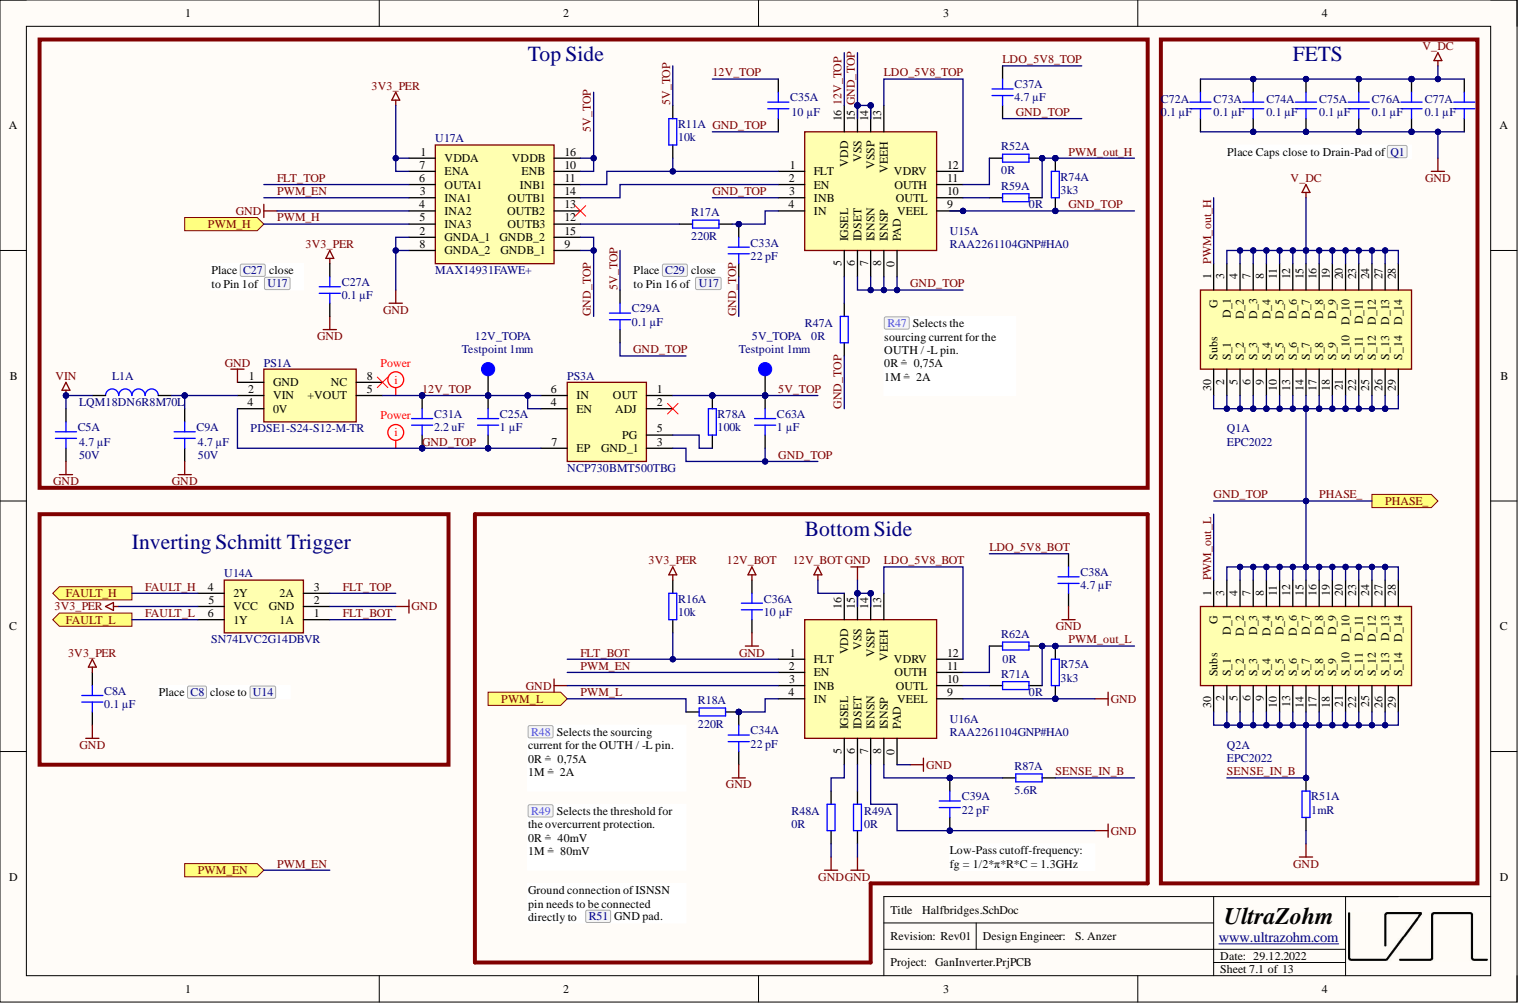
[picture p32: page 9]

Place Caps close to Drain-Pad of Q1

R48 Selects the sourcing
current for the OUTH / -L pin.

Low-Pass cutoff-frequency:
fg = 1/2*π*R*C = 1.3GHz

Ground connection of ISNSN
pin needs to be connected
directly to R51 GND pad.

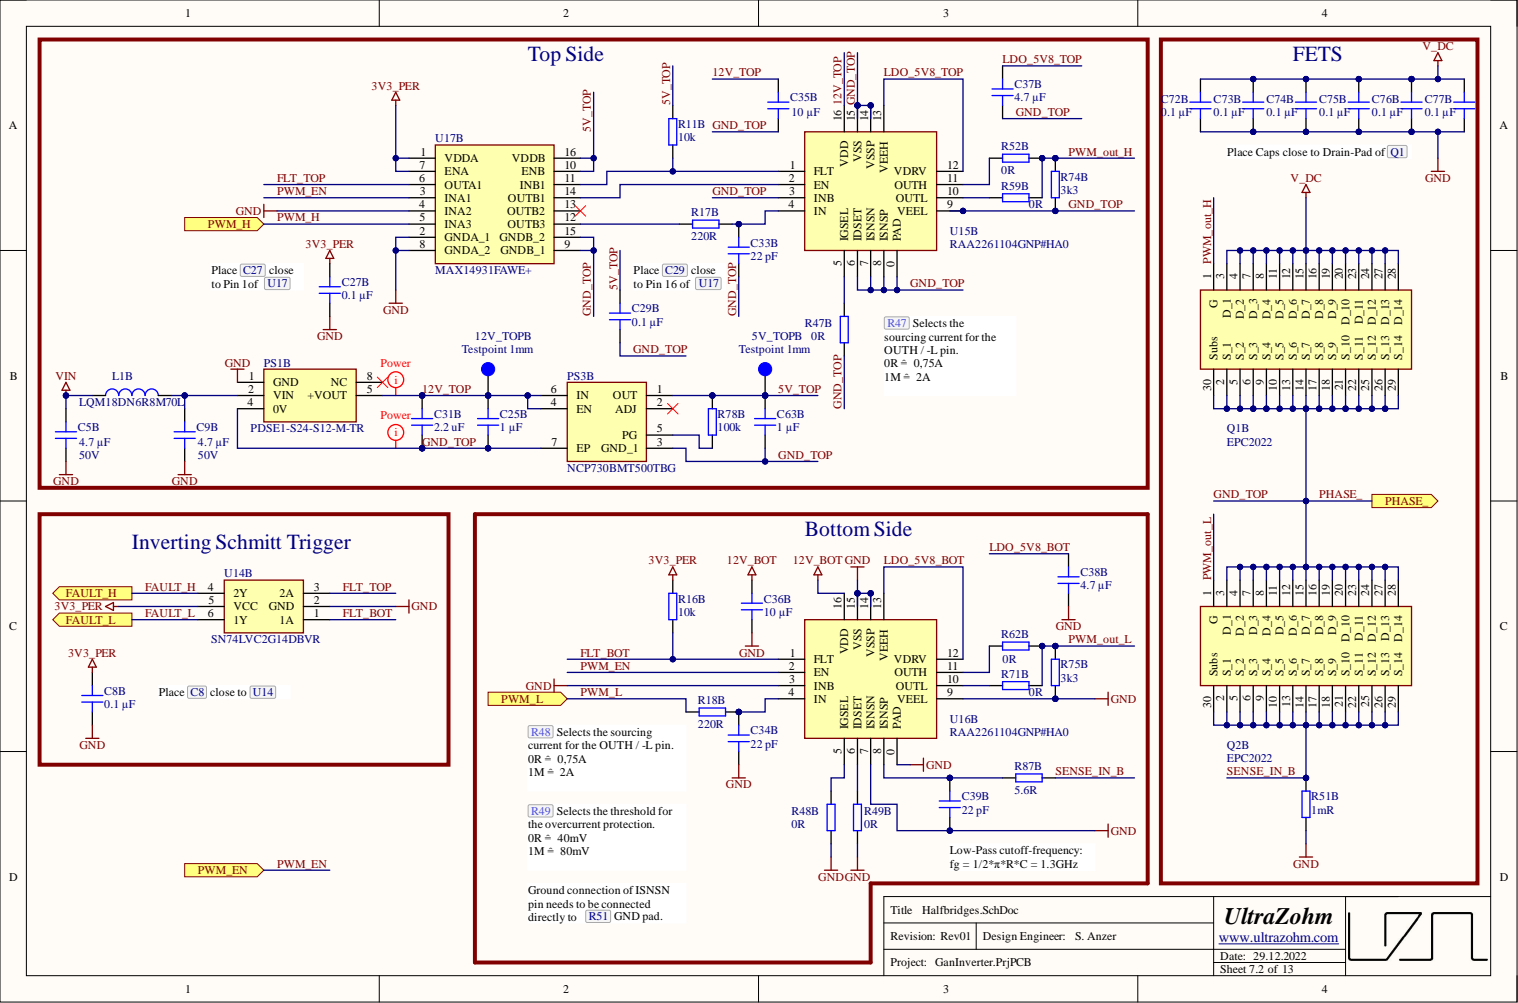
[picture p33: page 10]

Place Caps close to Drain-Pad of Q1

R48 Selects the sourcing
current for the OUTH / -L pin.

Low-Pass cutoff-frequency:
fg = 1/2*π*R*C = 1.3GHz

Ground connection of ISNSN
pin needs to be connected
directly to R51 GND pad.

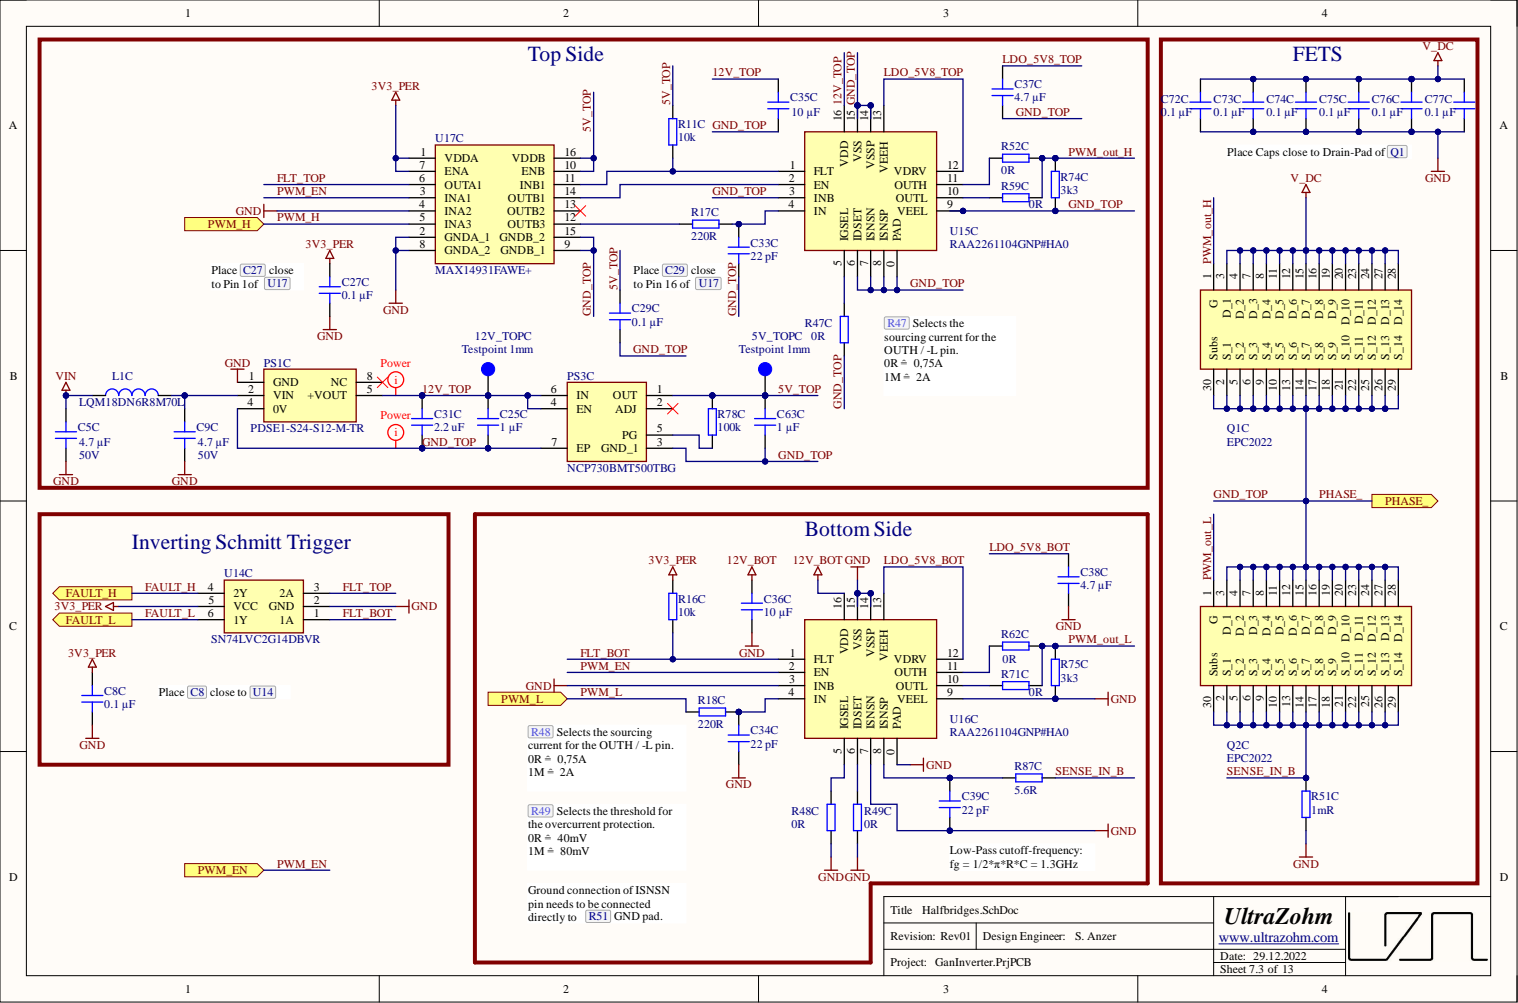
[picture p34: page 11]

Place Caps close to Drain-Pad of Q1

R48 Selects the sourcing
current for the OUTH / -L pin.

Low-Pass cutoff-frequency:
fg = 1/2*π*R*C = 1.3GHz

Ground connection of ISNSN
pin needs to be connected
directly to R51 GND pad.

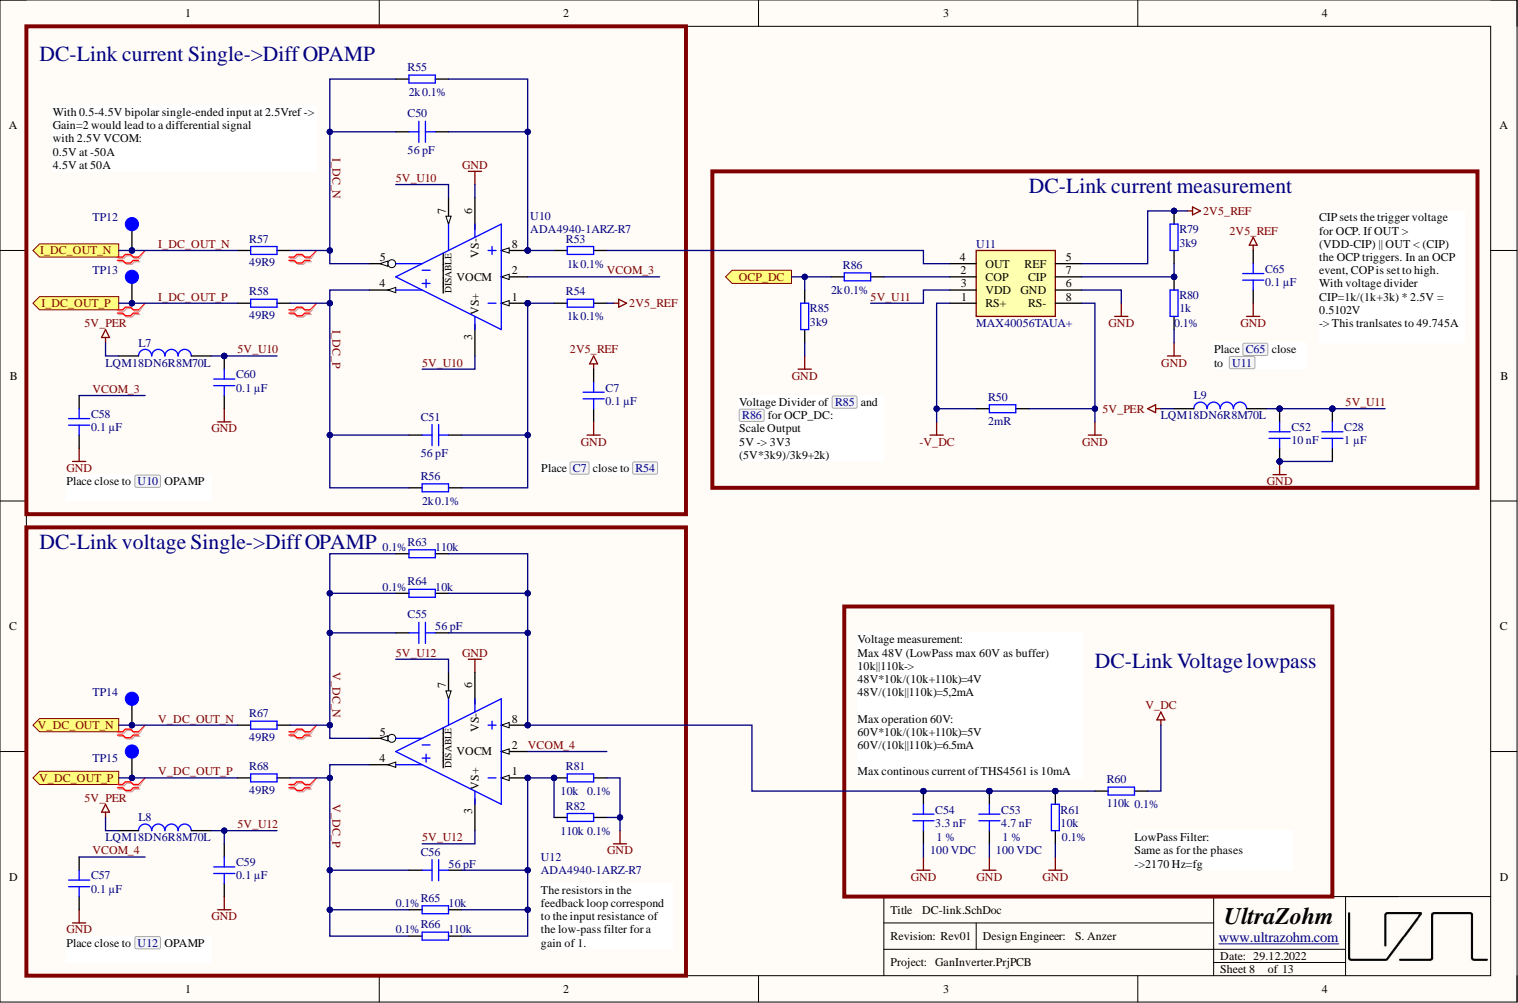
[picture p35: page 12]

DC-Link current Single->Diff OPAMP

With 0.5-4.5V bipolar single-ended input at 2.5Vref ->
Gain=2 would lead to a differentialsignal
with 2.5V VCOM:

DC-Link current measurement

CIP sets the trigger voltage
for OCP. If OUT >
(VDD-CIP) || OUT < (CIP)
the OCP triggers. In an OCP
event, COP is set to high.
With voltage divider
CIP=1k/(1k+3k) * 2.5V =

GND
Place close to U10 OPAMP

DC-Link voltage Single->Diff OPAMP

DC-Link Voltage lowpass

Max continous current of THS4561 is 10mA

LowPass Filter:
Same as for the phases

ADA4940-1ARZ-R7
The resistorsin the
feedback loop correspond
to the input resistance of
the low-pass filter for a
gain of 1.

Place close to U12 OPAMP

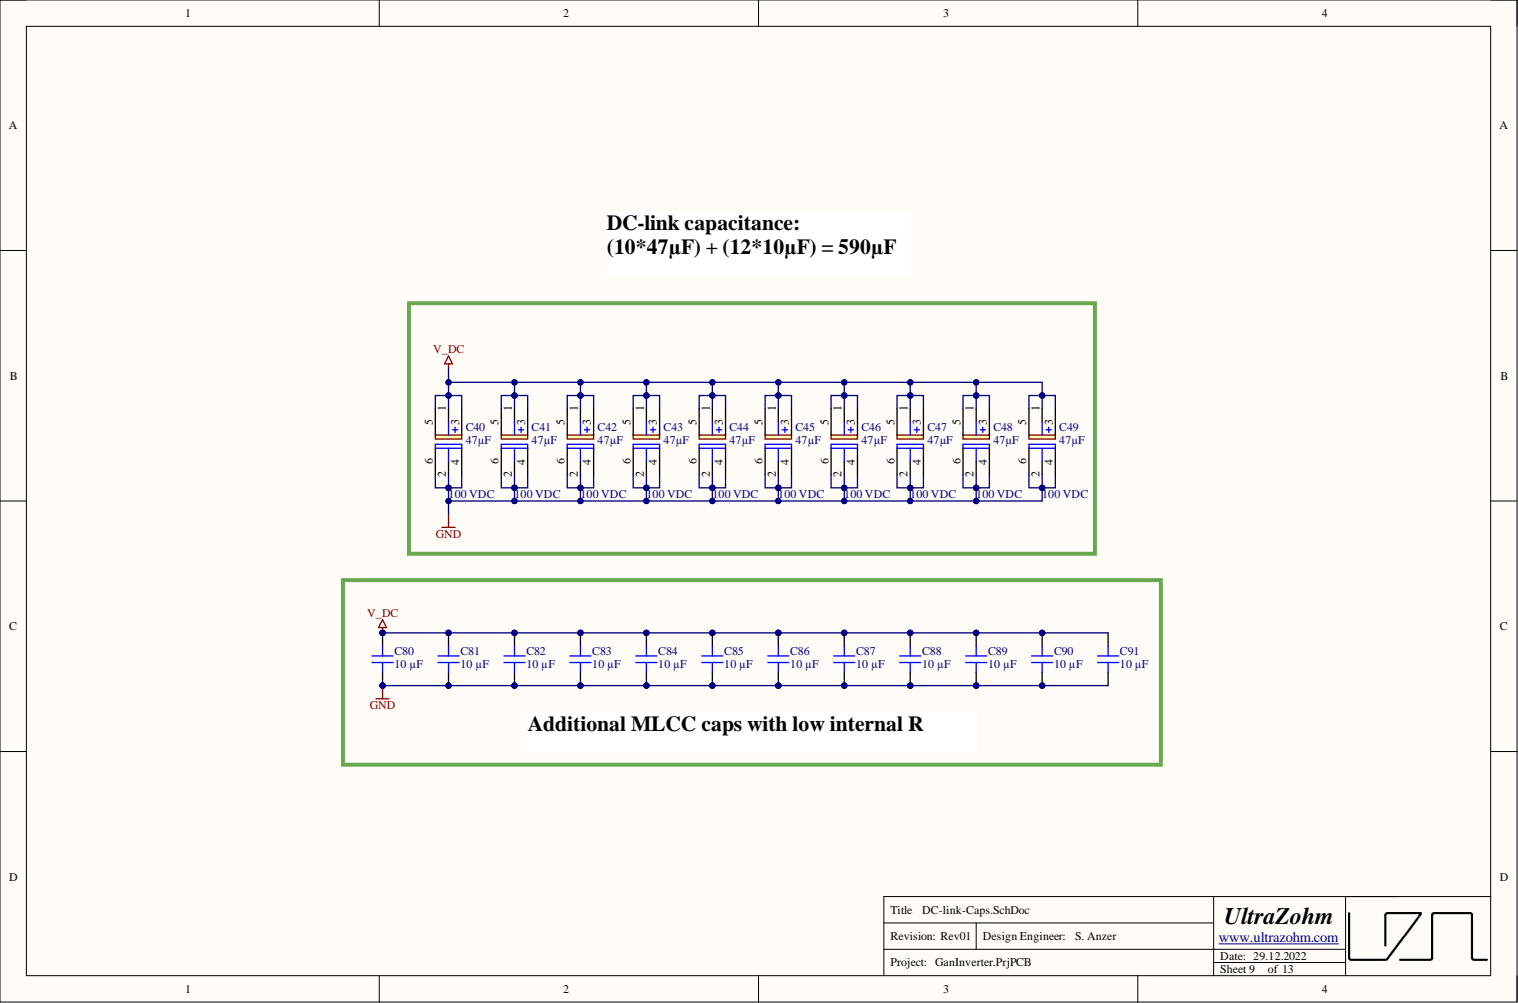
[picture p36: page 13]

100 VDC

Additional MLCC caps with low internal R

DC-link-Caps.SchDoc
