ultrazohm/uz_d_gan_inverter_epc/(list of files, drawings)

Other design files:
GaN_Inverter/Connectors.SchDoc
GaN_Inverter/DC-link-Caps.SchDoc
GaN_Inverter/DC-link.SchDoc
GaN_Inverter/DigitalCarrierJack.SchDoc
GaN_Inverter/EPC_2023_Q1a.SCHLIB
GaN_Inverter/GanInverter.PcbLib
GaN_Inverter/GanInverter.PrjPCB
GaN_Inverter/GanInverter.SchLib
GaN_Inverter/Halfbridges.SchDoc
GaN_Inverter/Phase_Measurements.SchDoc
GaN_Inverter/Reference.SchDoc
GaN_Inverter/TopSheet.SchDoc
