ultrazohm/uz_d_gan_inverter_epc/(commit log)

2023-02-28 Adds files from Simon
    [BOM_GanInverter_Inverter_V1_Rev01.xlsx, BOM_JLC_GanInverter_Inverter_V1_Rev01.xlsx, Connectors.SchDoc, DC-link-Caps.SchDoc, DC-link.SchDoc, DigitalCarrierJack.SchDoc, GanInverter.PcbLib, GanInverter.PrjPCB]
2023-04-28 schematics updated
    [Connectors.SchDoc, DC-link-Caps.SchDoc, DC-link.SchDoc, DigitalCarrierJack.SchDoc, EPC_2023_Q1a.PcbLib, EPC_2023_Q1a.SCHLIB, GanInverter.PcbLib, GanInverter.PrjPCB]
2023-05-01 Bottom Side voltage supply updated
    [Halfbridges.SchDoc, LowSideSupply.SchDoc, Phase_Measurements.SchDoc, Reference.SchDoc]
2023-05-08 Revert "Adds files from Simon"
    This reverts commit 1be201e50701ced471e365498098431e78512984.
    [BOM_GanInverter_Inverter_V1_Rev01.xlsx, BOM_JLC_GanInverter_Inverter_V1_Rev01.xlsx, Connectors.SchDoc, DC-link-Caps.SchDoc, DC-link.SchDoc, DigitalCarrierJack.SchDoc, GanInverter.PcbLib, GanInverter.PrjPCB]
2023-05-09 pcb synchronized
    [LowSideSupply.SchDoc]
2023-05-16 pcb layout improved with new shunt resistors added
    [GanInverter.PrjPCB, Halfbridges.SchDoc, Reference.SchDoc]
2023-05-18 halfbridge done
    [Halfbridges.SchDoc]
2023-05-21 fixed missing airwires, one halfbridge completed (c34 in pcb is still missing)
    [Connectors.SchDoc, DC-link-Caps.SchDoc, DC-link.SchDoc, DigitalCarrierJack.SchDoc, GanInverter.PrjPCB, Halfbridges.SchDoc, Phase_Measurements.SchDoc, Reference.SchDoc]
2023-05-23 copied room format of hb1 to hb2, top side half done, bot side fully problem
    [GanInverter.PrjPCB, Halfbridges.SchDoc]
2023-05-25 halfbridges done. (synchronization Problem of C34, R44 still continues)
    [GanInverter.PrjPCB]
2023-05-25 pcb done, annotation problem still continues
    [Halfbridges.SchDoc]
2023-05-26 fix issues in altium
    [DC-link.SchDoc, GanInverter.PrjPCB, Halfbridges.SchDoc, Phase_Measurements.SchDoc, TopSheet.SchDoc]
2023-05-31 polygons and tracks edited
    [DC-link-Caps.SchDoc, DC-link.SchDoc, GanInverter.PrjPCB, Halfbridges.SchDoc]
2023-06-04 Phase C is ready for review ( Gate Loop: got shorter with closer placement of Low Pass Filter. Power Loop: shortened as the switches got closer, Return Path in Layer 1 got wider, )
2023-06-15 library and paramterers edited
    [Connectors.SchDoc, DC-link.SchDoc, DigitalCarrierJack.SchDoc, EPC_2023_Q1a.PcbLib, GanInverter.PrjPCB, Halfbridges.SchDoc, Phase_Measurements.SchDoc, Reference.SchDoc]
2023-06-21 Pins to measure GND-SW still missing
    [BOM_JLC_GanInverter_Inverter_V1_Rev02.xlsx, Connectors.SchDoc, DC-link-Caps.SchDoc, DC-link.SchDoc, DigitalCarrierJack.SchDoc, GanInverter.PrjPCB, GanInverter.xlsx, Halfbridges.SchDoc]
2023-06-25 Pin headers and alternative CSA added, ground spring contacts are still missing
    [Connectors.SchDoc, DC-link.SchDoc, DigitalCarrierJack.SchDoc, Halfbridges.SchDoc, Phase_Measurements.SchDoc]
2023-06-27 Changes done according to review
    [Connectors.SchDoc, DC-link-Caps.SchDoc, DC-link.SchDoc, DigitalCarrierJack.SchDoc, GanInverter.PrjPCB, Halfbridges.SchDoc, Phase_Measurements.SchDoc, Reference.SchDoc]
2023-06-28 Adjustments made according to review/feedback
    [DC-link.SchDoc, Phase_Measurements.SchDoc]
2023-06-28 adjustments made according to feedbacks review
    [DC-link.SchDoc, Phase_Measurements.SchDoc]
2023-07-02 changes in progress
    [Connectors.SchDoc, DC-link.SchDoc, Phase_Measurements.SchDoc, Reference.SchDoc]
2023-07-02 ground probles are missing
    [Halfbridges.SchDoc, Phase_Measurements.SchDoc]
2023-07-02 ground probles are still missing
    [DC-link.SchDoc, GanInverter.PrjPCB, Phase_Measurements.SchDoc]
2023-07-03 holes for passive probes !!!
    [Connectors.SchDoc, DC-link-Caps.SchDoc, DC-link.SchDoc, DigitalCarrierJack.SchDoc, GanInverter.PrjPCB, Halfbridges.SchDoc, Phase_Measurements.SchDoc, Reference.SchDoc]
2023-07-03 holes for passive probes !!
2023-07-04 final version / ready-to-order
    [DigitalCarrierJack.SchDoc, Halfbridges.SchDoc]
2023-07-04 Project Outputs
    [BOM_GanInverter_Inverter_V1_Rev02.xlsx, BOM_JLC_GanInverter_Inverter_V1_Rev02.xlsx, GanInverter.xlsx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]
2023-07-05 bom with lcsc
    [BOM_JLC_GanInverter_Inverter_V1_Rev02_LCSC.xlsx]
2023-07-05 bom lcscs
    [BOM_JLC_GanInverter_Inverter_V1_Rev02.xlsx]
2023-07-05 bom and parts updated
    [BOM_GanInverter_Inverter_V1_Rev02.xlsx, Connectors.SchDoc, DC-link-Caps.SchDoc, DC-link.SchDoc, DigitalCarrierJack.SchDoc, GanInverter.PrjPCB, Halfbridges.SchDoc, Phase_Measurements.SchDoc]
2023-07-05 bom done
    [BOM_GanInverter_Inverter_V1_Rev02.xlsx, Connectors.SchDoc, DC-link-Caps.SchDoc, DC-link.SchDoc, DigitalCarrierJack.SchDoc, GanInverter.PrjPCB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]
2023-07-05 final BOM including all LCSC part numbers required
    [BOM_GanInverter_Inverter_V1_Rev02.xlsx, BOM_GanInverter_Inverter_V1_Rev02_LCSC.xlsx, BOM_JLC_GanInverter_Inverter_V1_Rev02.xlsx, BOM_JLC_GanInverter_Inverter_V1_Rev02_LCSC.xlsx, Connectors.SchDoc, DC-link-Caps.SchDoc, DC-link.SchDoc, DigitalCarrierJack.SchDoc]
2023-07-07 new gerber and nc files
    [GanInverter_Rev02.GBL, GanInverter_Rev02.GBO, GanInverter_Rev02.GBP, GanInverter_Rev02.GBS, GanInverter_Rev02.GM1, GanInverter_Rev02.GTL, GanInverter_Rev02.GTO, GanInverter_Rev02.GTP]
2023-07-11 second try for ordering (footprint of digital isolator and CSA have been changed)
    [BOM_JLC_GanInverter_Inverter_V1_Rev02.xlsx, DC-link.SchDoc, GanInverter.PrjPCB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]
